MOSW626/Swinging_on_a_swing_Robot_Project_-2021-/src/sketch_aug10e/data/fritzing_sweep.jpg

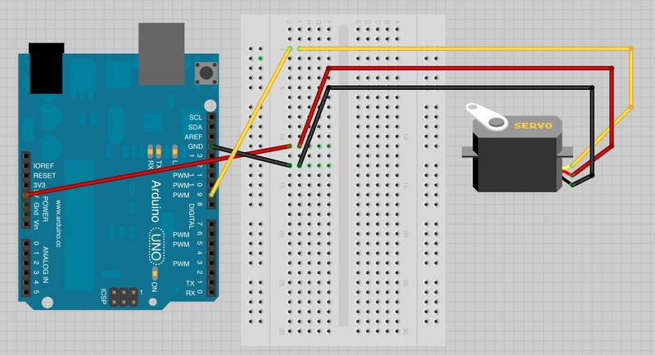
src/sketch_aug10e/data/fritzing_sweep.jpg
