MOSW626/Swinging_on_a_swing_Robot_Project_-2021-/README.md

# Swinging_on_a_swing_Robot_Project_-2021-

## 제 67회 전국과학전람회 작품
 - 지금까지의 과정 업로드용
 - 국무총리상 수상

## language
 : cpp (arduino)
