MOSW626/Swinging_on_a_swing_Robot_Project_-2021-/src/나는 그네를 어떻게 만들까2.pptx

## 나는 그네를 어떻게 만들까?

- 安延洙 -

## 외형

## Slide 3

## Slide 4

FF22DD
FF02FD
FFC23D
FF6897
FF30CF
FF18E7
FF7A85
FF10EF
…

속도 증가
속도 감소
시작 / 정지
가만히 있는 상태로
1번 케이스
2번 케이스
3번 케이스
4번 케이스
…

## Slide 5

적외선 리모컨 프로그래밍

#include <IRemote.h>

Irerecv irrecv(8);
decode_results results;
Void setup()
{
irrecv.enableIRIn();
pinmode(9, OUTPUT);
Serial.begin(9600);
}
Void loop()
{
if(irrecv.decode(&results))
{
Serial.println(results.value, HEX);
if(results.value == 0xFD30CF)
{
digitalWrite(9, HIGH);
}
else {
digitalWrite(9, LOW);
}
delay(30);
irrecv.resume();
}
}

// 적외선 센서가 연결된 디지털 핀
// 수신된 적외선 신호 저장 변수
// 적외선 센서 활성화
// 적외선 신호 해석
// 적외선 신호 값 출력
// 숫자 0 -> LED on
// else off
//초기화

## Slide 6

가속도 센서

라이브러리
=> MPU-6050_library,
I2Cdev_library

## Slide 7

가속도 센서

## Slide 8

레이저 거리 센서

라이브러리
=> vl53l0x-arduino

## Slide 9

레이저 거리 센서

#include <Wire.h>

#include <VL53L0X.h>

VL53L0X sensor;
void setup()
{
Serial.begin(9600);
Wire.begin();
sensor.setTimeout(500);
if (!sensor.init())
{
Serial.println("Failed to detect and initialize sensor!");
while (1) {}
}
// Start continuous back-to-back mode (take readings as
// fast as possible). To use continuous timed mode
// instead, provide a desired inter-measurement period in
// ms (e.g. sensor.startContinuous(100)).
sensor.startContinuous();
}
void loop()
{
Serial.print(sensor.readRangeContinuousMillimeters());
if (sensor.timeoutOccurred()) { Serial.print(" TIMEOUT"); }
Serial.println();
}

## Slide 10

초음파 거리 센서

- 사용전압 : 5V
- 사용전류 : 15mA

라이브러리
=> MPU-6050_library,
I2Cdev_library

## Slide 11

초음파 거리 센서

#define TRIG 9 //TRIG 핀 설정 (초음파 보내는 핀)

#define ECHO 8 //ECHO 핀 설정 (초음파 받는 핀)

void setup() {
Serial.begin(9600); //PC모니터로 센서값을 확인하기위해서 시리얼 통신을 정의해줍니다.
//시리얼 통신을 이용해 PC모니터로 데이터 값을 확인하는 부분은 자주사용되기 때문에
//필수로 습득해야하는 교육코스 입니다.
pinMode(TRIG, OUTPUT);
pinMode(ECHO, INPUT);
}
void loop()
{
long duration, distance;
digitalWrite(TRIG, LOW);
delayMicroseconds(2);
digitalWrite(TRIG, HIGH);
delayMicroseconds(10);
digitalWrite(TRIG, LOW);
duration = pulseIn (ECHO, HIGH); //물체에 반사되어돌아온 초음파의 시간을 변수에 저장합니다.
//34000*초음파가 물체로 부터 반사되어 돌아오는시간 /1000000 / 2(왕복값이아니라 편도값이기때문에 나누기2를 해줍니다.)
//초음파센서의 거리값이 위 계산값과 동일하게 Cm로 환산되는 계산공식 입니다. 수식이 간단해지도록 적용했습니다.
distance = duration * 17 / 1000;
//PC모니터로 초음파 거리값을 확인 하는 코드 입니다.
Serial.println(duration ); //초음파가 반사되어 돌아오는 시간을 보여줍니다.
Serial.print("\nDIstance : ");
Serial.print(distance); //측정된 물체로부터 거리값(cm값)을 보여줍니다.
Serial.println(" Cm");
delay(1000); //1초마다 측정값을 보여줍니다.

## Slide 12

코딩(code-up)
연수와 수빈이와 하린이는 전람회를 나가게 되었습니다. 이때 연수는 아두이노를 프로그래밍 해야 합니다. 이에 주어진 목표는 다음과 같습니다.

리모컨을 이용해서 조종 - FF22DD => 속도 증가 - FF02FD => 속도 감소 - FFC23D => 시작 / 정지 - FF6897 => 가만히 있는 상태로(초기 상태) - FF30CF => Case : 1 - FF18E7 => Case : 2 - FF7A85 => Case : 3 - FF10EF => Case : 4 - FF38C7 => Case : 5 - FF5AA5 => Case : 6 - FF42BD => Case : 7 - FF4AB5 => Case : 8 - FF52AD => Case : 9 중심을 지날 때를 기준으로 sensing하여 서보 모터의 속도를 조절 * Sensing방법 - 초음파 거리 센서 - 6축 가속도 센서 - 레이저 거리 센서 * 속도를 연속적이지 않게 조절 할 수 있도록 설계가 필요!

## Slide 13

Lcd i2c check

#include <Wire.h>

void setup()
{
Wire.begin();
Serial.begin(9600);
while (!Serial);
Serial.println("\nI2C Scanner");
}
void loop()
{
byte error, address;
int nDevices;
Serial.println("Scanning...");
nDevices = 0;
for(address = 1; address < 127; address++ )
{
Wire.beginTransmission(address);
error = Wire.endTransmission();
if (error == 0)
{
Serial.print("I2C device found at address 0x");
if (address<16)
Serial.print("0");
Serial.print(address,HEX);
Serial.println(" !");
nDevices++;
}
else if (error==4)
{
Serial.print("Unknow error at address 0x");
if (address<16)
Serial.print("0");
Serial.println(address,HEX);
}
}
if (nDevices == 0)
Serial.println("No I2C devices found\n");
else
Serial.println("done\n");
delay(5000);
}

## Slide 14

Lcd

#include <LiquidCrystal_I2C.h>

#include <Wire.h>

LiquidCrystal_I2C lcd(0x27, 16, 2);
void setup() {
lcd.init();
lcd.backlight();
}
void loop() {
int value = random(0, 3);
if (value == 0) {
lcd.setCursor(0,0);
` lcd.print(" KocoaFab.cc ");
}
else if (value == 1) {
lcd.setCursor(0,1);
lcd.print(" Hello World!! “);
}
else if (value == 2) {
lcd.setCursor(0,0);
lcd.print(" KocoaFab.cc ");
lcd.setCursor(0,1);
lcd.print(" Hello World!! ");
}
delay(1000);
lcd.clear();
}

## Slide 15
