MOSW626/Swinging_on_a_swing_Robot_Project_-2021-/src/회로도.pptx

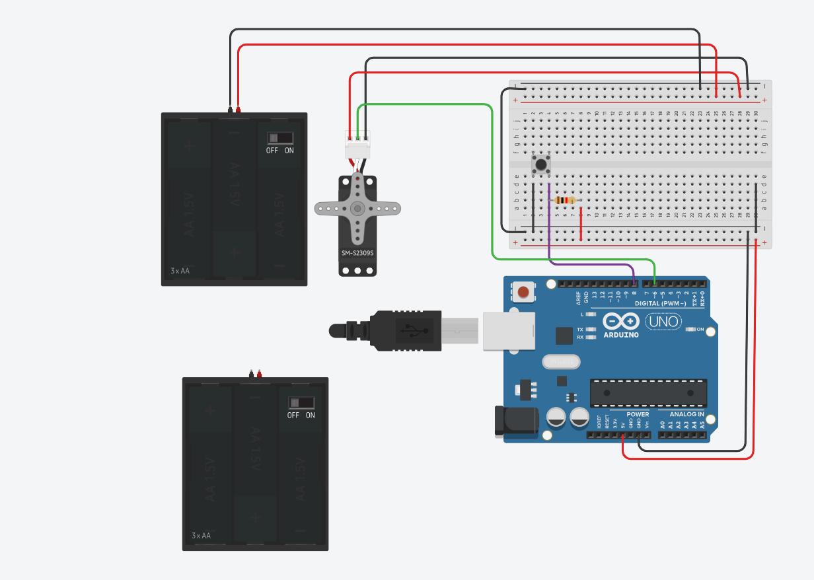
[picture p3: figure]
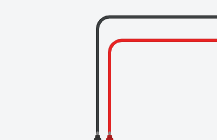
[picture p4: figure]
