MOSW626/Swinging_on_a_swing_Robot_Project_-2021-/j06720211129-1.pdf

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

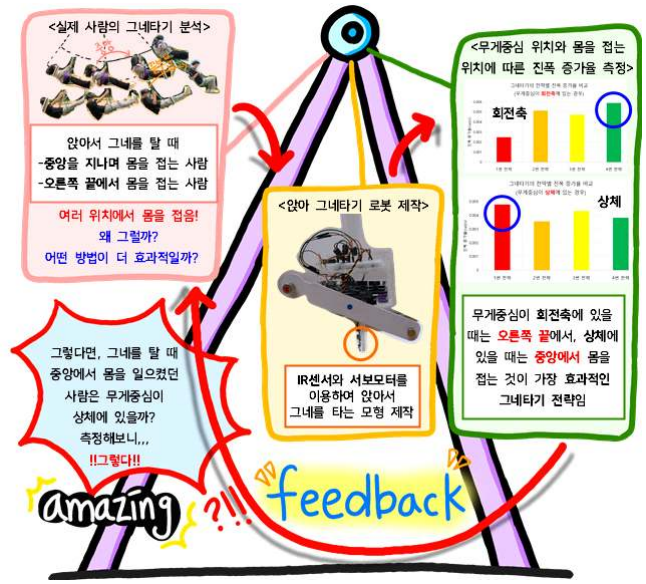
[picture p5: figure]
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
