MOSW626/Swinging_on_a_swing_Robot_Project_-2021-/j06720211129.pdf

### 출품번호

1129

# 제67회 전국과학전람회

# 사람마다 그네를 다르게 타는 이유는? 무게중심 위치에 따른 그네타기 전략 차이 탐구

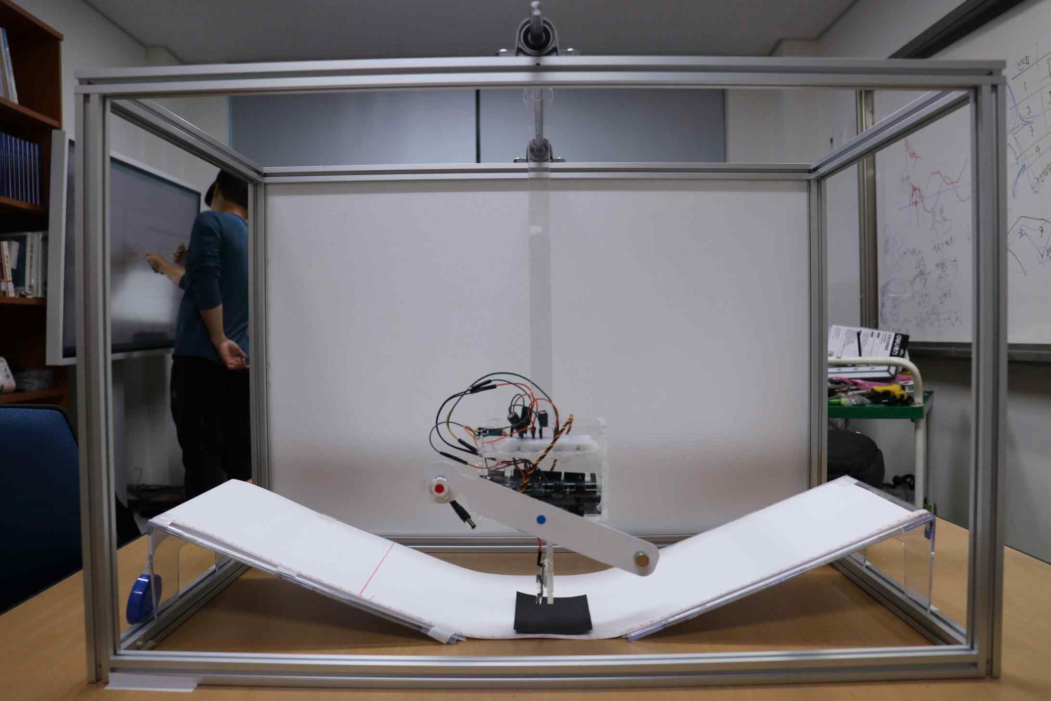
[picture p6: figure]

2021. 9. 6.

## 출품학생

## 지도교사

구분 | 학생작
출품부문 | 물리

【 차 례 】

I. 서론 ·······································································································1
1. 탐구 동기 ·························································································································1
2. 탐구 문제 및 가설 설정 ·······························································································2
3. 탐구 기간 ·························································································································3

### Ⅱ. 이론적 배경 및 선행 연구 조사 ····················································4

1. 역학적 에너지 보존 ·······································································································4
2. 돌림힘, 관성모멘트 및 각운동량 보존법칙 ······························································4
3. 선행 연구 조사 ···············································································································6

Ⅲ. 탐구 내용 ··························································································11

1. 탐구 문제 찾기. 사람은 실제로 어떤 방식으로 그네를 탈까? ····································11 가. 다양한 방법의 실제 그네타기 영상 분석 ·························································11 나. 새로운 탐구 문제 발견 및 탐구 문제 구체화 ·················································16
2. 탐구 준비. 그네 타기 모형(로봇) 만들기 ·································································17 가. 그네 타기 모형(로봇)의 필요성 ·············································································17 나. 그네 타기 모형(로봇) 만들기 ···············································································17 나. 그네 타기 모형(모형)의 작동 알고리즘 ·······························································19
3. 메인 탐구. 몸을 접는 위치에 따른 진폭 증가율 비교 ········································21 가. 실험 설계 및 실험 방법 ·························································································21 나. 실험 결과 ···················································································································23
1) 무게중심이 회전축에 있을 때 진폭 증가율 비교 ···········································23
2) 무게중심이 상체에 있을 때 진폭 증가율 비교 ···············································24
4. 추가 탐구. 메인 탐구 결과의 역도 성립할까? ························································24 가. 메인 탐구 결과를 역으로 실제 그네 타기에 적용 ···········································24 나. 실제 사람의 무게중심 및 회전축의 위치 측정 ·················································25

### Ⅳ. 결론 및 향후 탐구 계획 ································································27

Ⅴ. 참고 문헌 ··························································································28

<그림 차례>
[그림 1[ 앉아서 그네타기에서 몸을 접는 시점이 다른 두 사람 ················································· 1 [그림 2] 역학적 에너지 보존 법칙 ····································································································· 4 [그림 3] 회전운동과 병진운동에서의 식의 비교 ····························································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

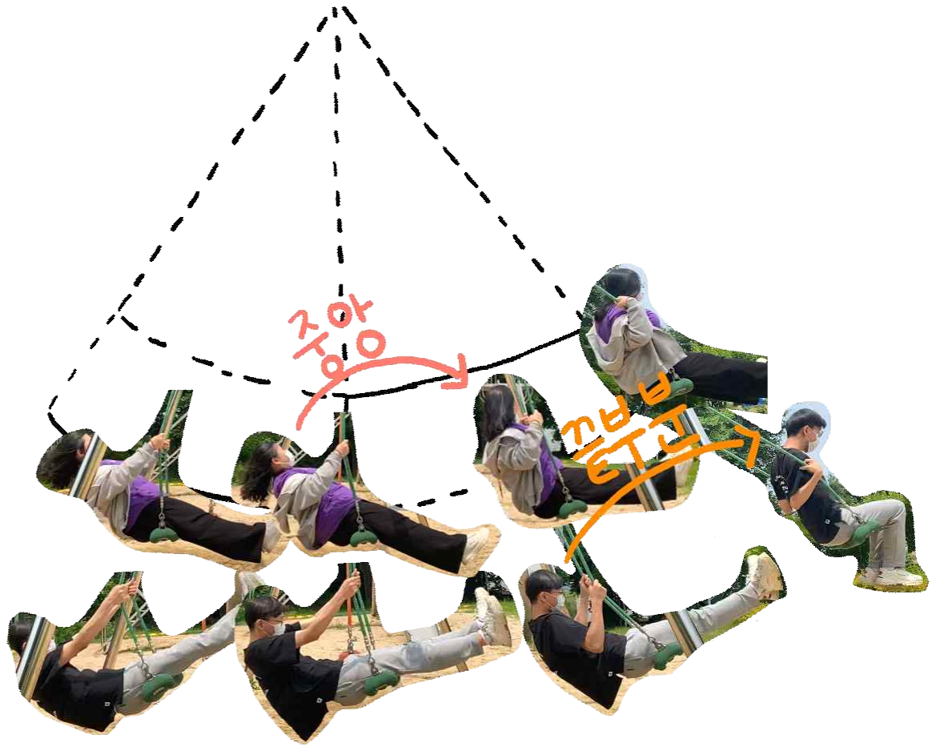
[picture p7: figure]

- 1 -

# Ⅰ 서 론

### 1. 탐구 동기

학교 근처 초등학교에서 어린 동생과 같이 그네를 타러 갔었다. 그네 타기에 어려 움을 겪고 있던 동생에게 그네 타는 방법을 가르쳐 주려는 데, 그네 타는 방법을 명확하게 설명할 수 없었다. 평소 너무도 쉽게 그네를 타고 있었기에 당연히 알고 있다고 생각했던 그네 타기의 역학적 원리를 모르고 있었음을 깨닫고, 이후 학교 물리 동아리에서 ‘어떻게 하면 그네를 잘 탈 수 있을까?’라는 주제로 토론을 진 행하게 되었다. 토론을 해보니 사람마다 그네를 타는 방법이 다양했고, 무엇보다도 자신이 어떻게 그네를 타는지 명확하게 설명할 수 있는 사람이 거의 없었다. 이런 궁금증으로 그네 타기를 주제로 탐구를 시작하였는데, 인터넷 조사를 통해

그네 타기의 역학적 원리에 대해 알아보니 기본 원리가 잘 설명되어 있어서 막상 우리가 탐구 해야할 문제를 찾기가 어려웠다. 그래서 처음에는 탐구 문제를 찾기 위해 다양한 방법으로 그네를 타기도 하고, 그네 타기를 표현할 수 있는 그네 타기 로봇 모형을 만들어 실험을 해 보기도 하였다.

[그림 1[ 앉아서 그네타기에서 몸을 접는 시점이 다른 두 사람

그러다가 앉아서 그네 타기에서 몸을 일으키는 시점이 이론과 다름에도 그네를 잘 타는 사례를 발견하고 탐구 문제로 구체화 하였다.

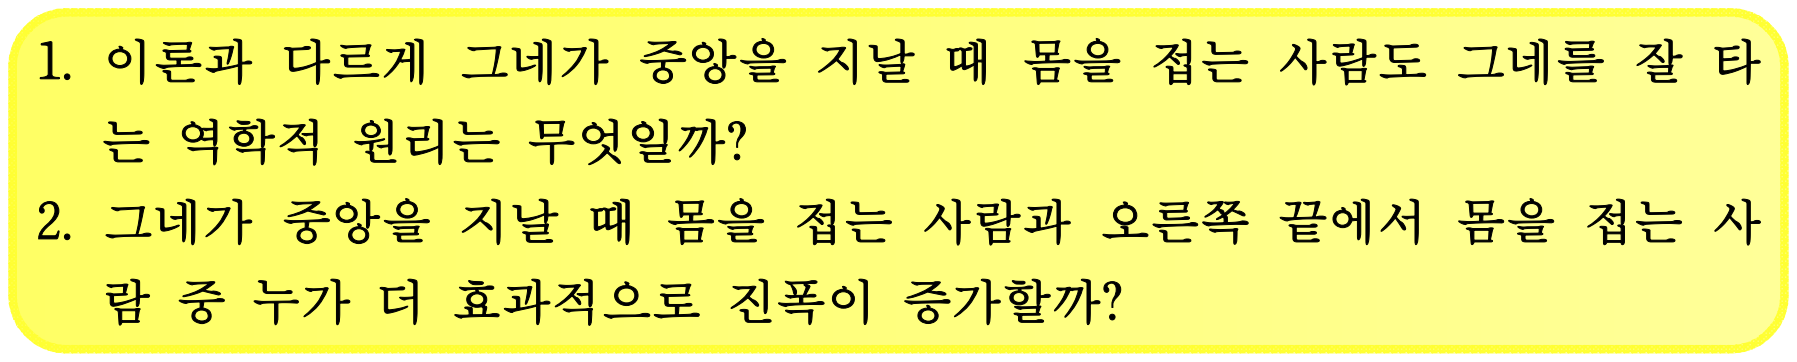
[picture p8: figure]
역학적; 원리는; 무엇일까?; 효과적으로; 진폭이; 증가할까?
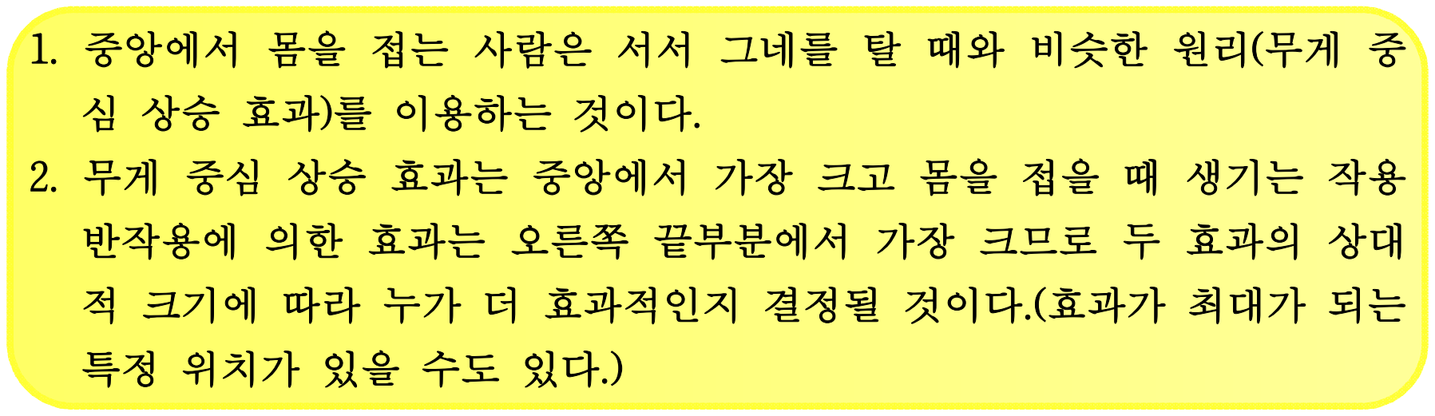
[picture p9: figure]
반작용에; 효과는; 오른쪽; 끝부분에서; 크므로; 효과의; 크기에; 효과적인지; 결정될; 것이다.(효과가; 최대가; 위치가
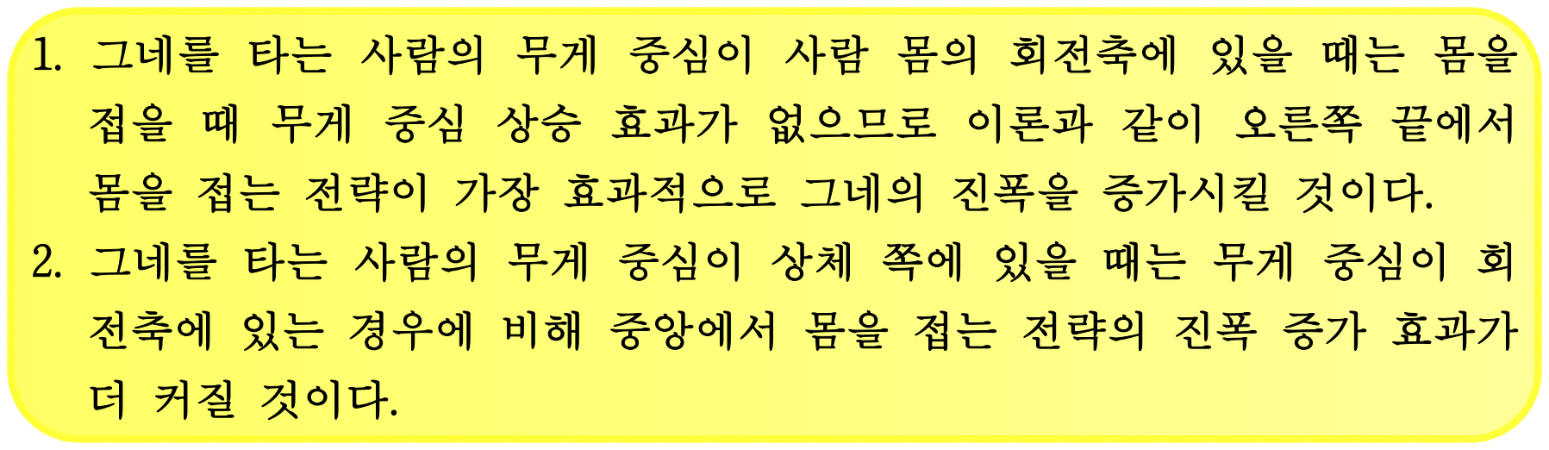
[picture p10: figure]
효과가; 없으므로; 이론과; 오른쪽; 끝에서; 전축에; 경우에; 중앙에서; 전략의; 것이다.

- 2 -

### 2. 탐구 문제 및 가설 설정

선행 연구와 이론에 따르면 앉아서 그네 타기는 오른쪽 끝(최고점)에서 몸을 접을 때 가장 효과적으로 진폭이 증가한다고 하였다. 그런데 우리가 직접 그네를 타면서 발견한 사례 중 하나는 그네가 중앙(최저점)을 지날 때 몸을 접으면서도 그네를 잘
타는 | 사례였다. 우리는 | 이것을 | 탐구 | 문제로 | 삼고 | 다음과 | 같이 | 구체화 | 하였다. 탐구 | 문제
1. | 이론과 | 다르게 | 그네가 | 중앙을 | 지날 | 때 | 몸을 | 접는 | 사람도 | 그네를 | 잘 | 타
2. | 그네가 | 중앙을 | 지날 | 때 | 몸을 | 접는 | 사람과 | 오른쪽 | 끝에서 | 몸을 | 접는 | 사
이러한 | 탐구 | 문제에 | 대한 | 우리의 | 예상 | 답변은 | 다음과 | 같다. 예상 | 답변
1. | 중앙에서 | 몸을 | 접는 | 사람은 | 서서 | 그네를 | 탈 | 때와 | 비슷한 | 원리(무게 | 중
심 | 상승 | 효과)를 | 이용하는 | 것이다. 2. | 무게 | 중심 | 상승 | 효과는 | 중앙에서 | 가장 | 크고 | 몸을 | 접을 | 때 | 생기는 | 작용
이러한 | 예상 | 답변을 | 검증 | 가능한 | 내용으로 | 정리한 | 우리의 | 가설은 | 다음과 | 같다. 가설 | 설정
1. | 그네를 | 타는 | 사람의 | 무게 | 중심이 | 사람 | 몸의 | 회전축에 | 있을 | 때는 | 몸을
몸을 | 접는 | 전략이 | 가장 | 효과적으로 | 그네의 | 진폭을 | 증가시킬 | 것이다. 2. | 그네를 | 타는 | 사람의 | 무게 | 중심이 | 상체 | 쪽에 | 있을 | 때는 | 무게 | 중심이 | 회

- 3 -

### 3. 탐구 기간

연구내용 | 추진 시기(월)
4월 | 5월 | 6월 | 7월 | 8월
초 | 중 | 말 | 초 | 중 | 말 | 초 | 중 | 말 | 초 | 중 | 말 | 초 | 중 | 말
탐구 주제 선정 | ▶ | ▶ | | | | | ▶ | ▶ | ▶
선행 연구 조사 및 분석 | | ▶ | ▶ | ▶ | ▶ | ▶ | ▶ | ▶ | ▶
이론적 배경 파악 | | ▶ | ▶ | ▶ | ▶ | ▶ | ▶
탐구설계 | | | | ▶ | ▶ | ▶ | ▶ | ▶ | ▶ | ▶ | ▶ | ▶
탐구 수행 | | | | | ▶ | ▶ | ▶ | ▶ | ▶ | ▶ | ▶ | ▶ | ▶ | ▶ | ▶
그네 모형 제작 | | | | | | ▶ | ▶ | ▶ | | | ▶ | ▶ | ▶ | ▶
결과 정리 및 보고서 작성 | | | | | | ▶ | ▶ | ▶ | | | | ▶ | ▶ | ▶ | ▶

<표 1> 탐구 기간 및 절차

4월에 탐구를 시작할 때는 막연하게 그네 타기의 역학적 원리에 대한 궁금증에서 시작하였다. 선행 연구와 인터넷 자료 조사를 통해 기본적인 원리를 파악할 수 있 었지만 우리가 탐구 해야 할 주제를 구체화 하는데 어려움이 있었다. 그래서 구체 적인 탐구 문제를 발견하기 위해 직접 그네를 타기도 하고, 로봇을 만들어 실험을 해 보기도 하던 중 탐구 문제를 발견하여 구체화하고 그에 따른 새로운 실험 설계 와 로봇 제작을 통해 탐구를 진행하였다. 이러한 탐구 과정을 위 <표 1>에 나타내 었다.

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

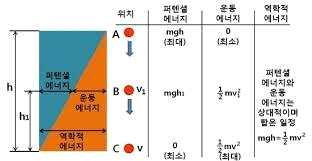
[picture p11: figure]

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

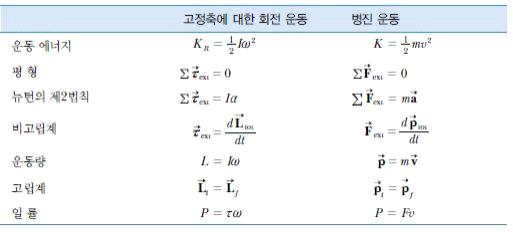
[picture p12: figure]
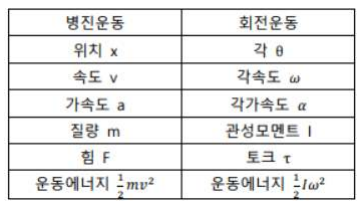
[picture p13: figure]

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

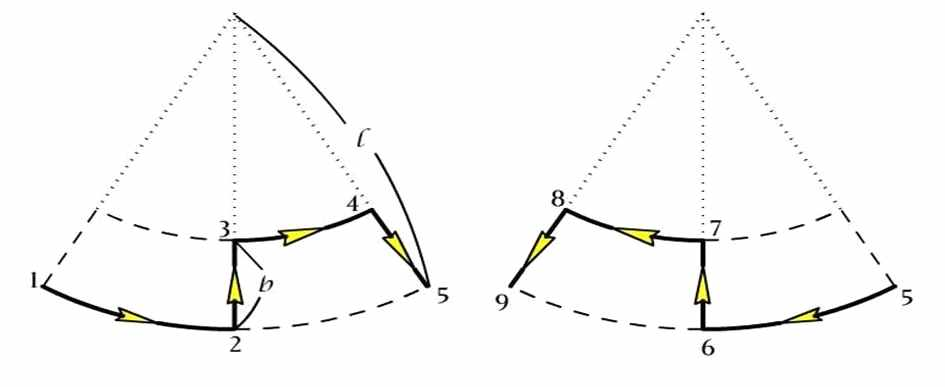
[picture p14: figure]

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

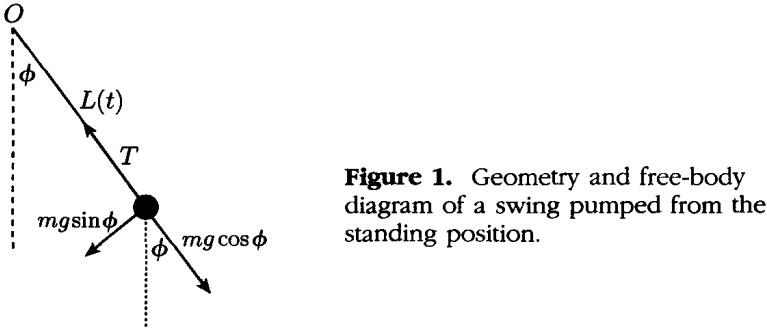
[picture p15: figure]

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

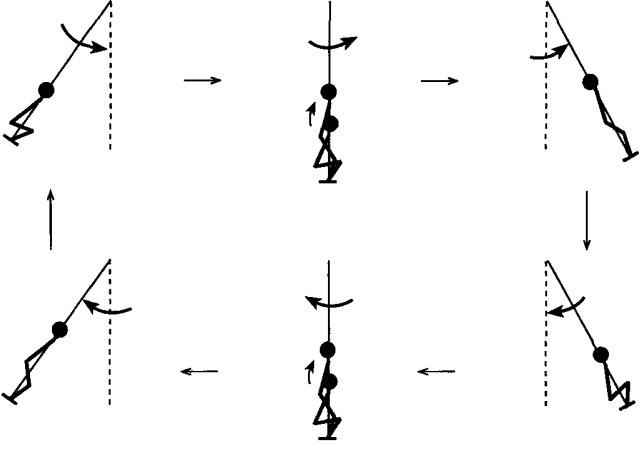
[picture p16: figure]
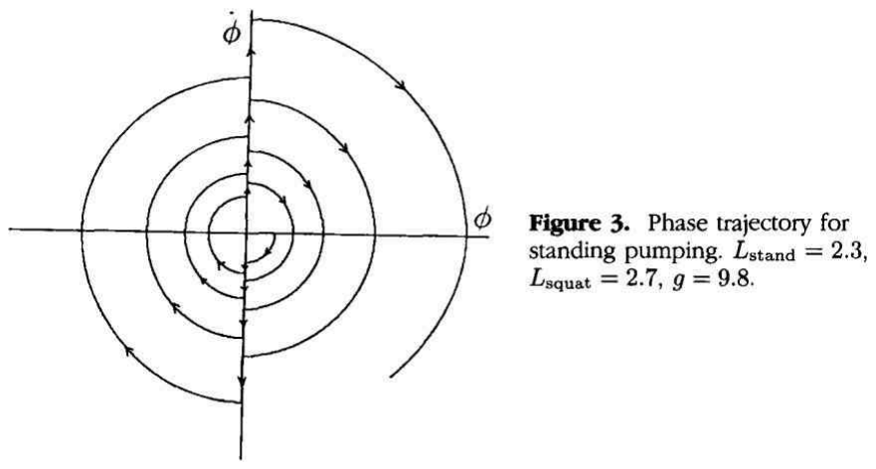
[picture p17: figure]

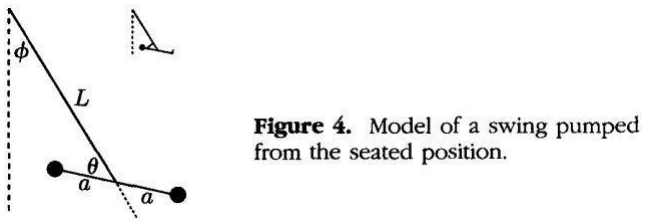
[picture p18: figure]
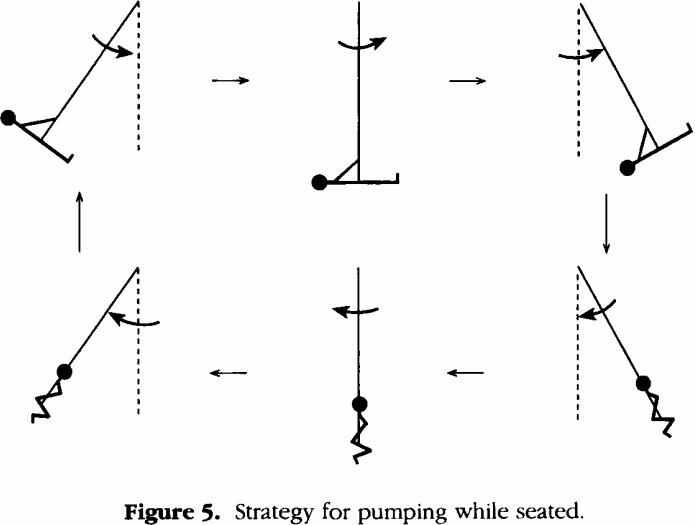
[picture p19: figure]

- 9 -

[그림 9] 앉아 타는 그네의 단순 모형

[그림 9]은 사람이 그네를 탈 때를 좌우에 각각 1:1 질량비의 바벨(barbell)을 달아 표현하였고, 강체의 줄과 두 바벨 사이의 강체가 이루는 각 을 설정하여 변수를 하나 더 늘렸다. 앉아 타는 그네는 [그림 9]처럼 간단한 모식도를 통해 나타낼 수 있다. 이를 서서 타는 그네와 같은 방법으로 중력과 돌림힘의 관계를 수식을 정리

하면

sin으로 나타낼 수 있다.

[그림 10] 앉아 타는 그네의 모식도
이 식을 [그림 10]의 상황에 적용하면 최고점 또는 이 0인 아주 짧은 시간에

를 변화시킴으로써 그 반작용으로 반대 방향의 의 변화를 만들어 내는 방법으로 그네를 타는 것을 알 수 있다. 이를 위상 공간에 나타내면 [그림 11]과 같은 각속도

-각변위 그래프를 얻을 수 있다.

인 지점, 즉 그네 타기에서의 최고점에서 가

증가하는 모습을 볼 수 있다.

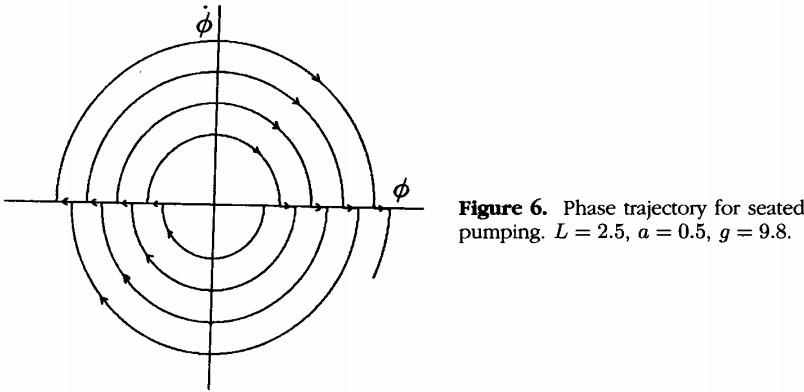
[picture p20: figure]
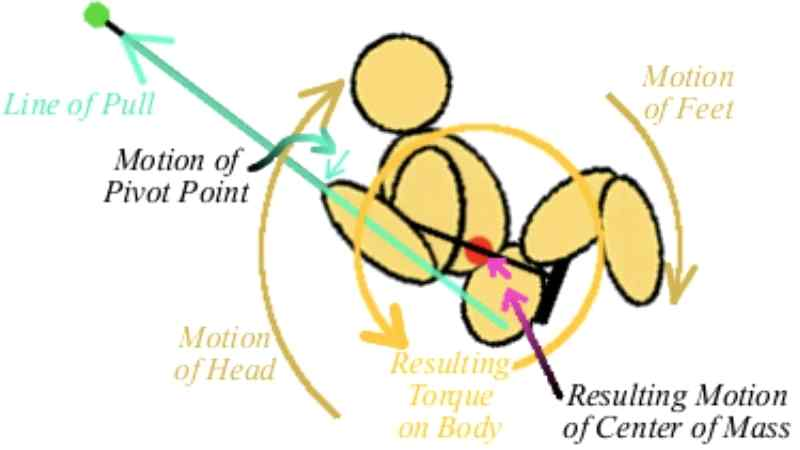
[picture p21: figure]

- 10 -

[그림 11] 앉아 타는 그네의 각속도-각변위 그래프

### 다. 나! 그네, KOSMOS (KAIST부설 한국과학영재학교 온라인 과학매 거진 코스모스) 이준민 (2020)

내용 요약 | 본 탐구와 다른 점
서서 타는 그네와 앉아서 타는 그네의 물리적 원리를 각운동량 보존법칙과 역 학적 에너지 보존법칙, 그리고 돌림힘 을 통해 설명하고, 두 그네 타기 모델 에 대하여 | 앞에서 소개한 선행 연구들의 내용을 재해석하여 정리한 문헌으로서 탐구를 진행한 내용은 아니다.

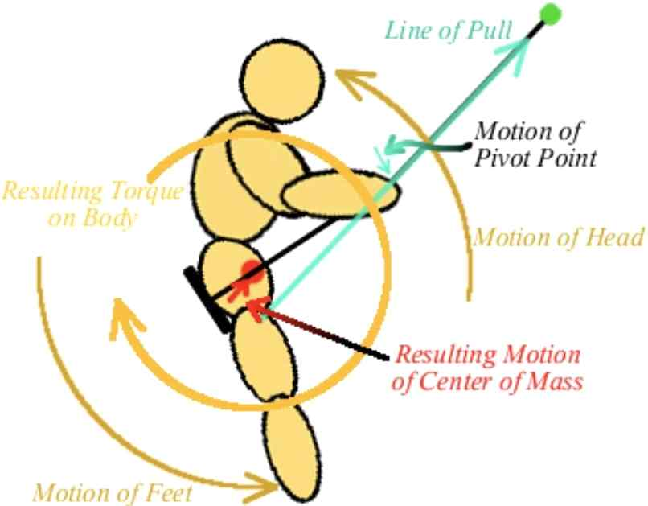
[picture p22: figure]

서서 그네 타기의 물리적 원리와 앉아서 그네 타기의 원리에 대해 설명한다. 위에 서 소개한 선행 연구의 내용과 거의 같으나 앉아서 타는 모델에서 그네의 줄을 강 체로 설정하지 않고 꺾이는 것으로 설명하는 점이 다르다.
또한 그네 타는 동작을 세분화해서 학습시킨 후, 그 동작들 중에 가장 높이 올라 가는 것을 다시 골라내 마치 다윈의 자연선택설처럼 반복하면 나오는 모델이 그네
[그림 12] 앉아 타는 그네의 돌림힘(1) | [그림 13] 앉아 타는 그네의 돌림힘(2)

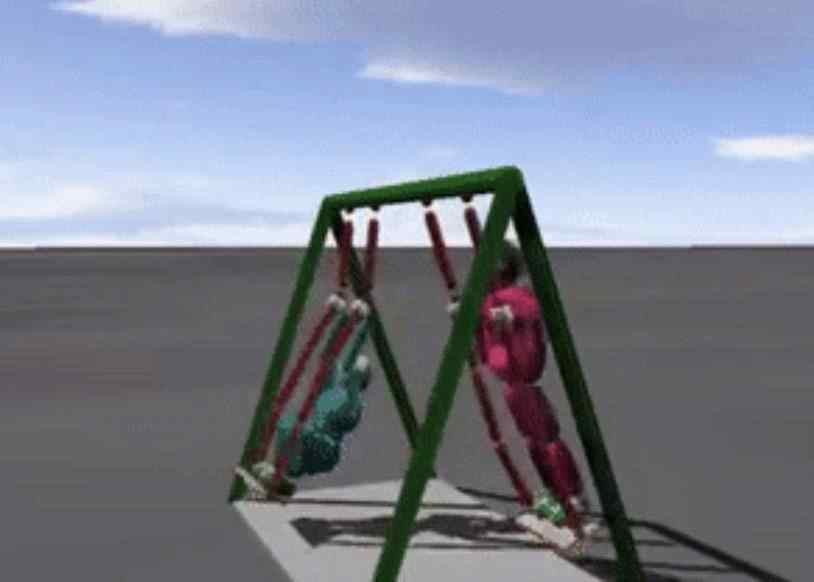
[picture p23: figure]
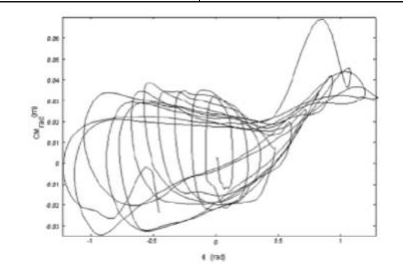
[picture p24: figure]

- 11 -

를 잘 탄다는 유전 알고리즘을 소개하고
있다. 이 연구는 이론적인 설명과 연구
사례를 소개하였을 뿐 실제 실험을 통해
진행한 부분은 없다. 우리는 실제 사람의
그네타는 영상을 분석하고, 그네 타는 로
봇을 만들어 선행연구에서 설명하는 그네
타기 원리가 실제 상황에 어떻게 적용되
는지 알아고보자 하며 나아가서는 유전
알고리즘 등을 활용하여 최적의 그네 타

### 는 방법에 대해 알아내고자 한다. 라. Pumping a playground swing, Auke A. Post 외 3인 (2007)

[그림 15] 실제 앉아서 그네타기에서 무게 중심의 이동

마. The pumping of a swing from the seated position, William B.

Case 외 1인 (1999) 앉아서 그네 타기의 원리를 요약 정리한 교육 논문.

[그림 14] 유전적 알고리즘 실행 장면

내용 요약 | 본 탐구와 다른 점
30명의 사람들을 표본 집단으로 하여 그네 를 태우고, 그네 회전축과 사람 사이 각도 에 따른 무게중심 위치 그래프 등을 통해 실제 사람들이 그네를 어떻게 타는지 설명 하였다. | 실제 그네 타는 사람의 모습을 정량적으로 분석하였으나, 본 연구처럼 사람의 무게중 심이나 체형에 따른 연구는 아니다.

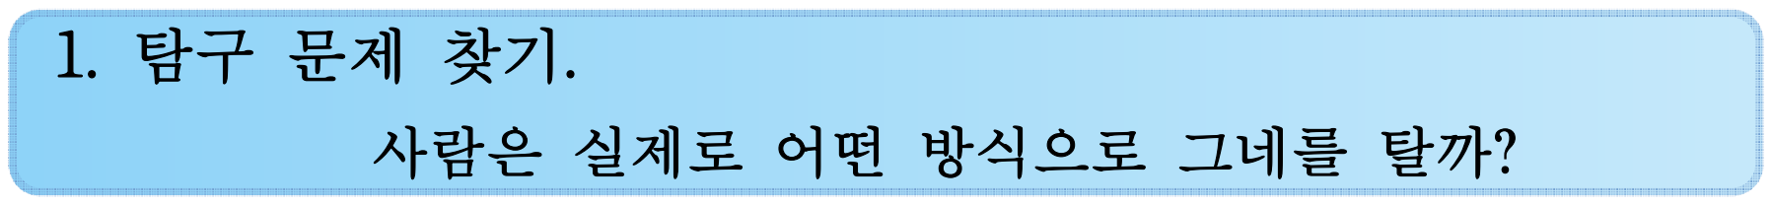
[picture p25: figure]
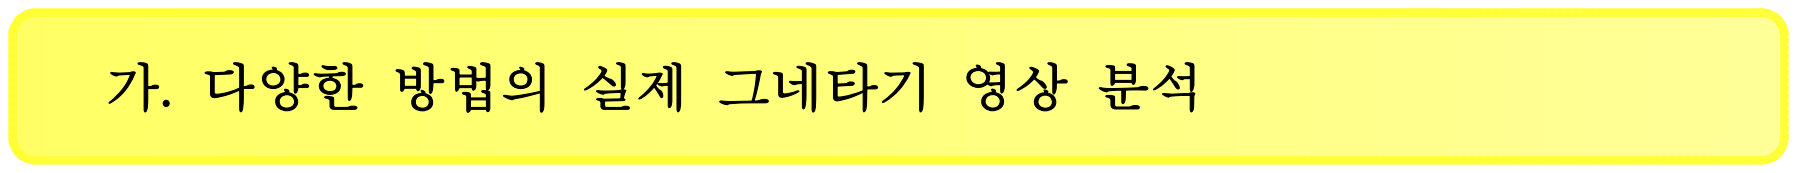
[picture p26: figure]
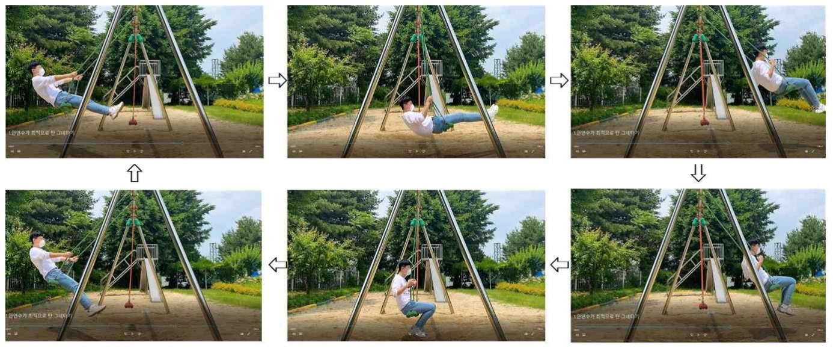
[picture p27: figure]

- 12 -
사람은 | 실제로 | 어떤 | 방식으로 | 그네를 | 탈까? 가. | 다양한 | 방법의 | 실제 | 그네타기 | 영상 | 분석
1) 다양한 방법의 실제 그네 타기 영상 촬영
실제 그네 타기를 분석하여 기존 연구와 어떻게 다른지 알아보기로 하였다. 이를 위해 인근 초등학교에 직접 가서 여러 가지 상황을 설정하여 그네타기 영상을 촬영
하였다. 상황 | 상체 | 다리 | 감속/

가속

1. 변수를 제한하지 않고 마음대로 그네 타기 | ○ | ○ | 가속
2. 다리를 움직이지 않고 상체만 움직인 그네 타기 | ○ | × | 가속
3. 상체를 움직이지 않고 다리만 움직인 그네 타기 | × | ○ | 가속
4. 3번 경우에서 반대로 다리를 움직여 감속을 시킨 그네
타기 | × | ○ | 감속

표 6 다양한 그네 타기 방안

상황 1. 변수를 제한하지 않고 마음대로 그네 타기

[그림 16] 변수를 제한하지 않고 마음대로 그네 타기

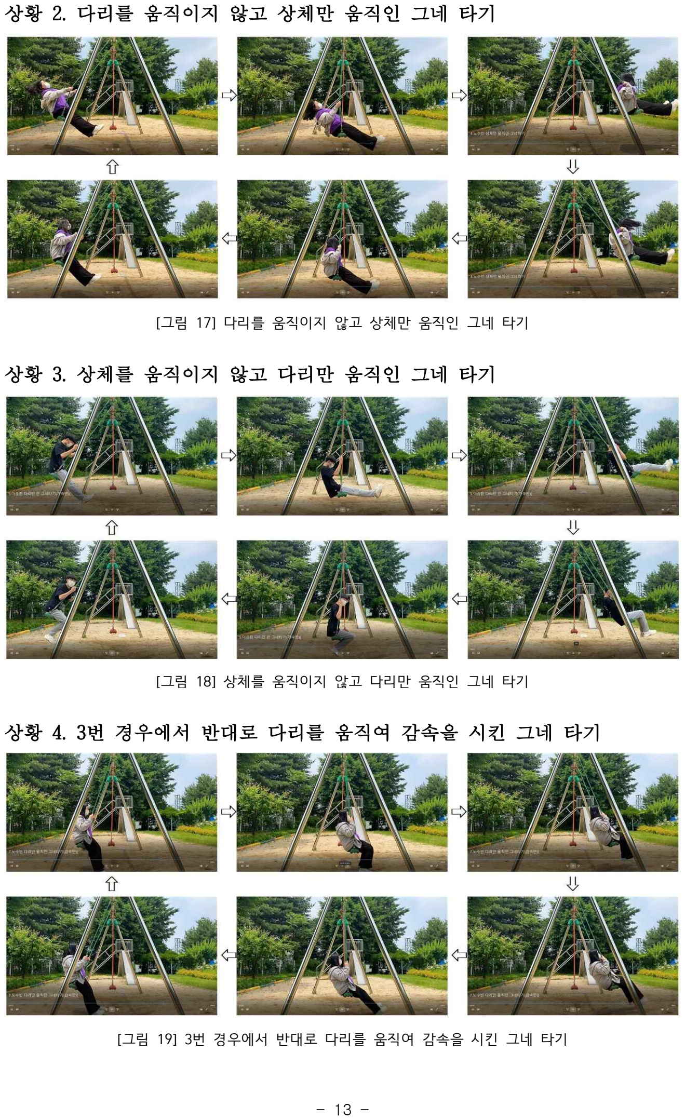
[picture p28: page 16]

- 13 -

상황 2. 다리를 움직이지 않고 상체만 움직인 그네 타기

[그림 17] 다리를 움직이지 않고 상체만 움직인 그네 타기

상황 3. 상체를 움직이지 않고 다리만 움직인 그네 타기

[그림 18] 상체를 움직이지 않고 다리만 움직인 그네 타기

상황 4. 3번 경우에서 반대로 다리를 움직여 감속을 시킨 그네 타기

[그림 19] 3번 경우에서 반대로 다리를 움직여 감속을 시킨 그네 타기

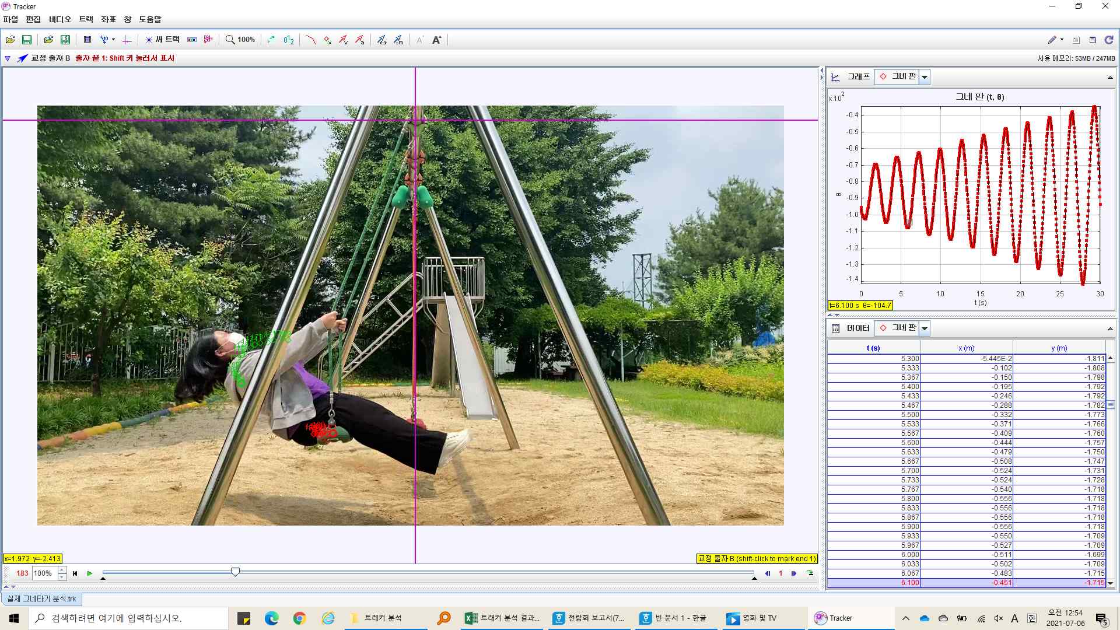
[picture p29: figure]

- 14 -

이와 같이 다양한 방법으로 그네를 타는 영상을 촬영해 관찰해 본 결과 선행 연 구에서 설명한 내용과 어느 정도 비슷한 경향을 보인다. 그네가 오른쪽 끝에 왔을 때 몸을 당기고 다리를 굽히며, 그네가 왼쪽 끝에 왔을 때 몸을 눕히고 다리를 펴 는 행동을 할 때 그네가 잘 가속되는 모습을 보였고 반대로 그네가 오른쪽 끝에 왔 을 때 다리를 펴고 왼쪽 끝에 왔을 때 다리를 굽히는 방법으로 그네를 탔을 때 진 폭이 점점 줄어드는 모습을 관찰할 수 있었다.
그러나 선행 연구에서는 아주 짧은 시간에 순간적으로 몸을 눕히거나 다리를 펴 는 행동 등을 하는 것으로 설정하여 계산하였는데 실제 그네타기에서는 순간적으로 움직이려면 무한대에 가까운 가속도와 힘이 필요하므로 그럴 수 없다. 즉, 어느 정 도 시간을 가지고 천천히 몸을 눕히거나 다리를 접는 행동을 하는 것이다. 이에 대

### 해 정확히 알아볼 필요를 느꼈다. 2) Tracker를 이용한 실제 그네 타기 영상 분석

위에서 설정한 상황 1과 같이 몸과 다리를 모두 사용한 그네 타기 영상을 Tracker로 분석하였다. 가) 탐구 방법

1초에 30프레임인 동영상을 15초간 각각 그네와 어깨에 질점을 찍는다. 30(1초에 30프레임)×15(최대 20초간)×2(그네와 줄에 질점을 찍어)=1200개의 질점을 찍어 시 간에 따른 두 질점의 위치 데이터를 얻고 Excel 프로그램을 이용하여 그네 각도() 와 그네 각속도(), 사람 각도()를 구하여 그래프로 나타내었다.

[그림 20] 그네 타기 Tracker 분석 장면

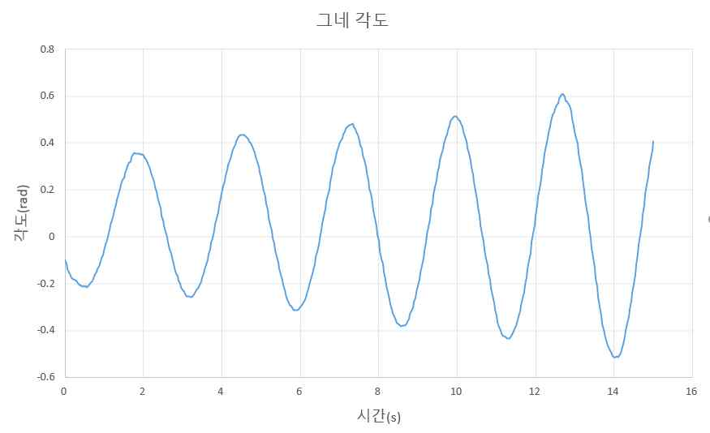
[picture p30: figure]
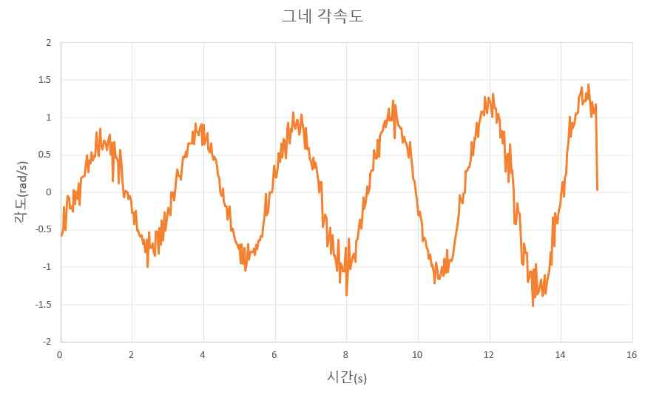
[picture p31: figure]
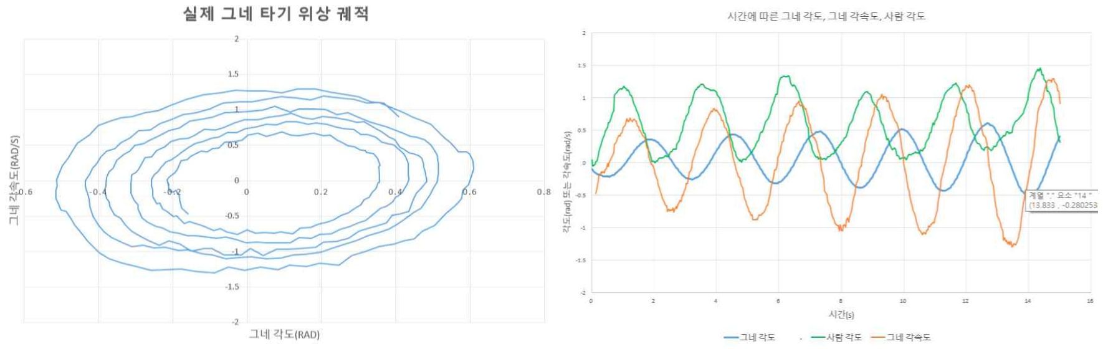
[picture p32: figure]

- 15 -

나) 탐구 결과 분석

[그림 21] 시간에 따른 그네 각도 그래프 | [그림 22] 시간에 따른 그네의 각속도 그래프

시간에 따른 그네 각도와 각속도는 [그림 21, 22]와 같이 점점 진폭이 커지는 모습 을 보였다. 그네의 움직임을 위상 공간에 나타내면 위 [그림 23]과 같이 나선형으로 점점 진폭

이 커지는 모습을 볼 수 있다. 그러나 선행 연구에서와 같이 한순간에 속도나 변위 가 커지는 모습은 볼 수 없으며 연속적으로 증가하는 모습을 볼 수 있다.

[그림 23] 그네 운동의 위상 공간 궤적 그래프 | [그림 24] 그네 각도, 각속도, 사람 각도 시간에 따른 그네 각도, 각속도, 사람 각도를 함께 나타내면 [그림 24]와 같다. 그

네 각속도 변화가 거칠어서 알아보기 쉽도록 Excel의 추세선으로 대체하였다. 그네가 오른쪽으로 갈 때와 왼쪽으로 갈 때 모두 그네가 중앙(각도가 0인 위치)을 지난 후 사람 각도의 변화가 커지고 그에 따라 속도가 커지는 모습을 볼 수 있다. (자세히 보면 그네 속도 그래프의 봉우리가 오른쪽이 조금 더 두껍다.)

다) 이론과 실제 그네 타기 비교
선행 연구에서는 그네가 중앙을 지날 때 순간적으로 일어섬으로써 무게중심이 순 간적으로 올라가면서 그네의 속도가 빨라지는 방법과 그네가 양 끝에 있을 때 사람 의 각도 변화를 순간적으로 줌으로써 그네의 각변위가 증가하는 방법에 의해 그네 를 탄다고 설명하고 있다. 또한 실제로 우리가 그네를 타고 촬영하여 분석한 결과로는 앉아서 그네를 탈 때

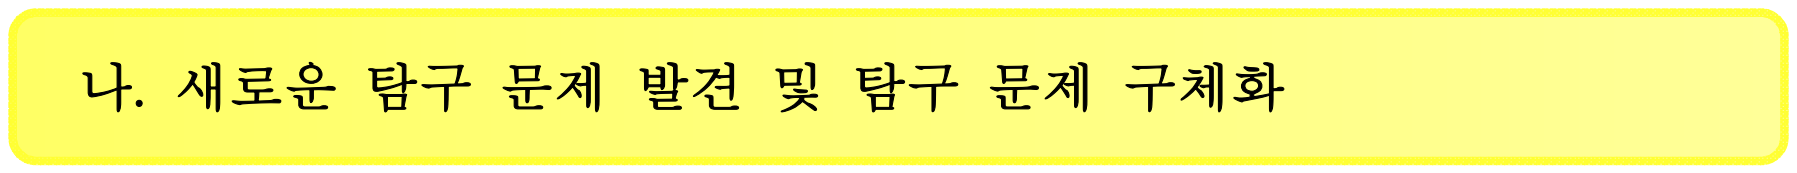
[picture p33: figure]
새로운; 구체화
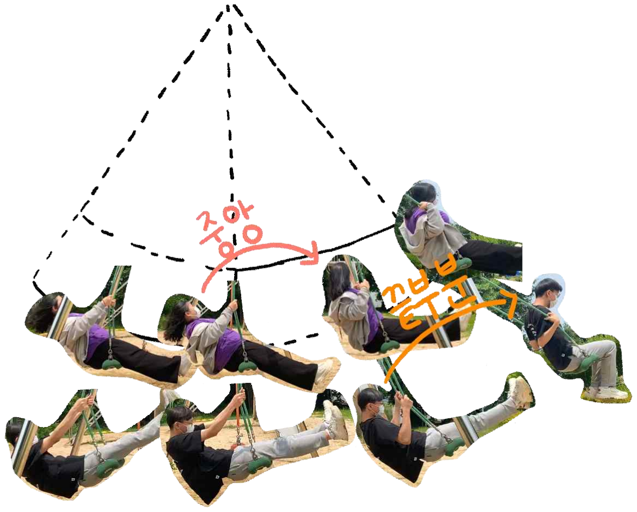
[picture p34: figure]

- 16 -

도 서서 그네 타기의 주된 방식인 ‘무게 중심 상승에 의한 속도 증가 효과’를 이 용하는 사람도 있는 것으로 보였지만, 그네의 진폭 증가 과정이 연속적이고 복합적 으로 작용했다는 것을 제외하면 선행 연구에서 언급한 두 가지 원리가 잘 적용되는 듯 보였다.

이론과 실제의 비교 결과, 실제 그네 타기도 선행 연구에서 설명한 그네 타기와 별반 다르지 않아서 구제적인 탐구 문제를 정하기 못하고 계속 실제 그네 타기 영 상을 분석하고 있었다. 그러던 어느날 그네를 타는 우리들의 모습을 보던 중, ‘어? 우리들 각자 그네 타는 방법이 조금씩 다르네..!’라는 생각이 들었고, 좀 더 자세히 관찰하자 사람마다 몸을 접는 위치가 조금씩 다르다는 점을 발견할 수 있었다.

[그림 25] 앉아서 그네타기에서 몸을 접는 시점이 다른 두 사람 그네가 중앙(최하점)을 지날 때 몸을 접기 시작하는 사람이 있었고, 그네가 오른쪽 끝(최고점)에 거의 도달했을 때 몸을 접는 사람도 있었다. 여기서 우리는 이 두 사람이 ‘무게 중심 상승 효과’와 ‘돌림힘의 작용 반작용

효과’중 어떤 것을 주로 사용할지 궁금증이 생겼고, ‘이 둘 중 어느 전략이 더 효과적으로 빠르게 진폭을 증가시키는 전략일지 궁금해졌다.’
그래서 우리는 이 두 가지 궁금증을 새로운 탐구 문제로 정하고 이후의 탐구를 진 행하였다.

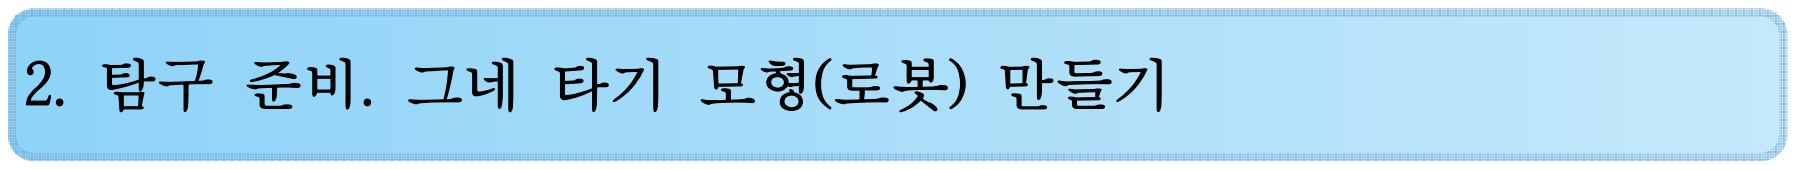
[picture p35: figure]
만들기
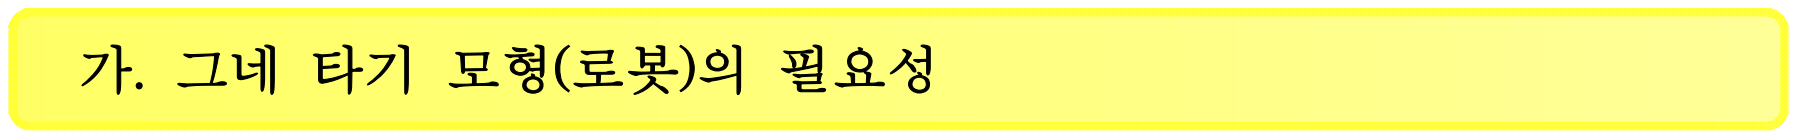
[picture p36: figure]
필요성
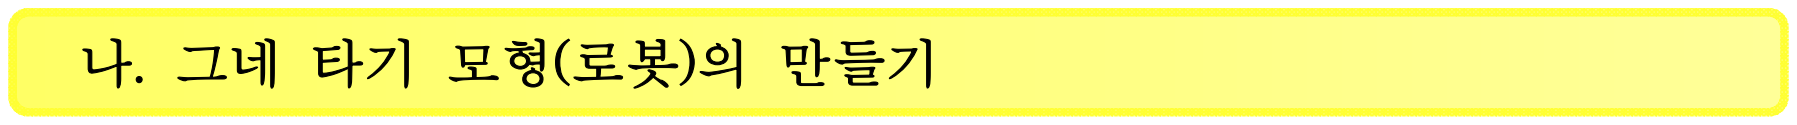
[picture p37: figure]
만들기
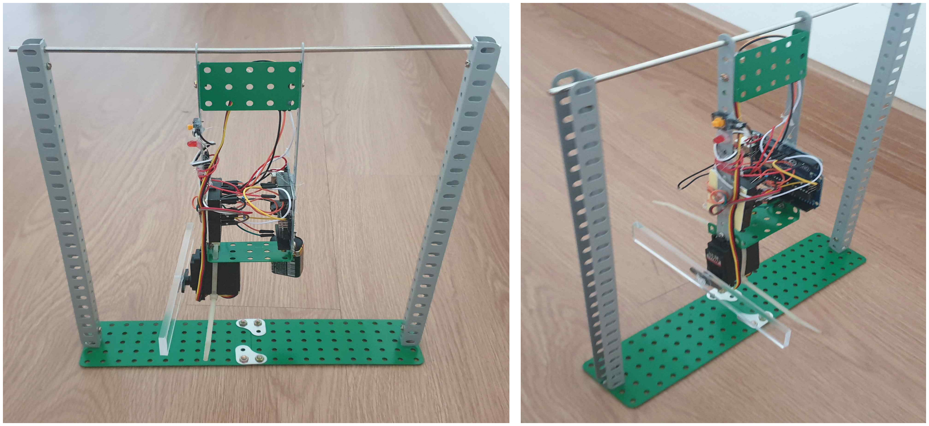
[picture p38: figure]

- 17 -

구체적인 탐구 문제를 발견한 후, 처음에는 사람이 직접 그네를 타면서 몸을 접 는 시점을 달리하면서 그네의 진폭이 커지는 속도를 측정하고자 했다. 그러나 매번 일정한 위치에서 몸을 접는 것도 불가능했고, 다리를 접거나 팔을 당기는 등의 행 동을 통제하기가 어려워서 우리가 조작할 변인인 ‘몸을 접는 위치(시점)’를 조작 할 수 있으면서도 다른 변인은 통제가 되는 로봇을 만들 필요가 있었다.

1) 근근이 탄생

[그림 26] 처음 제작한 앉아서 그네 타기 로봇(근근이 1호) 과학상자를 이용해 그네를 만들고 ]아크릴판으로 사람의 몸을 나타내었다. 서보모 터와 아두이노로 아크릴판을 움직이는데, 센서 없이 미리 입력해 놓은 주기와 각도 로 아크릴판이 시계 방향과 반시계 방향으로 반복적으로 움직이도록 하였다. 사람 의 몸을 나타내는 아크릴판을 이후의 설명에서는 ‘근근이’로 부르겠다. 그네의 고유 주기(약 0.84초)와 근근이가 움직이는 주기를 정확하게 맞추자 그네의

진폭이 점점 커지는 모습을 관찰할 수 있었다. 그러나 주기가 조금만 달라져도(0.01 초) 그네의 진폭이 커지지 않았다. 우리가 실제 그네를 탈 때는 고정된 주기로 움직이는 것이 아니라 그네의 움직임

에 맞추어 우리의 몸을 움직이므로 근근이에게도 그네의 위치를 알 수 있는 센서가 필요하다고 생각하였다. 또한 그네의 크기가 작아서 주기가 짧아서 눈으로 그네의 정확한 움직임을 관찰하

기 어려웠고, 서보모터의 힘이 약해 근근이의 무게를 늘렸을 때 제대로 움직이지 못하는 문제도 있었다.

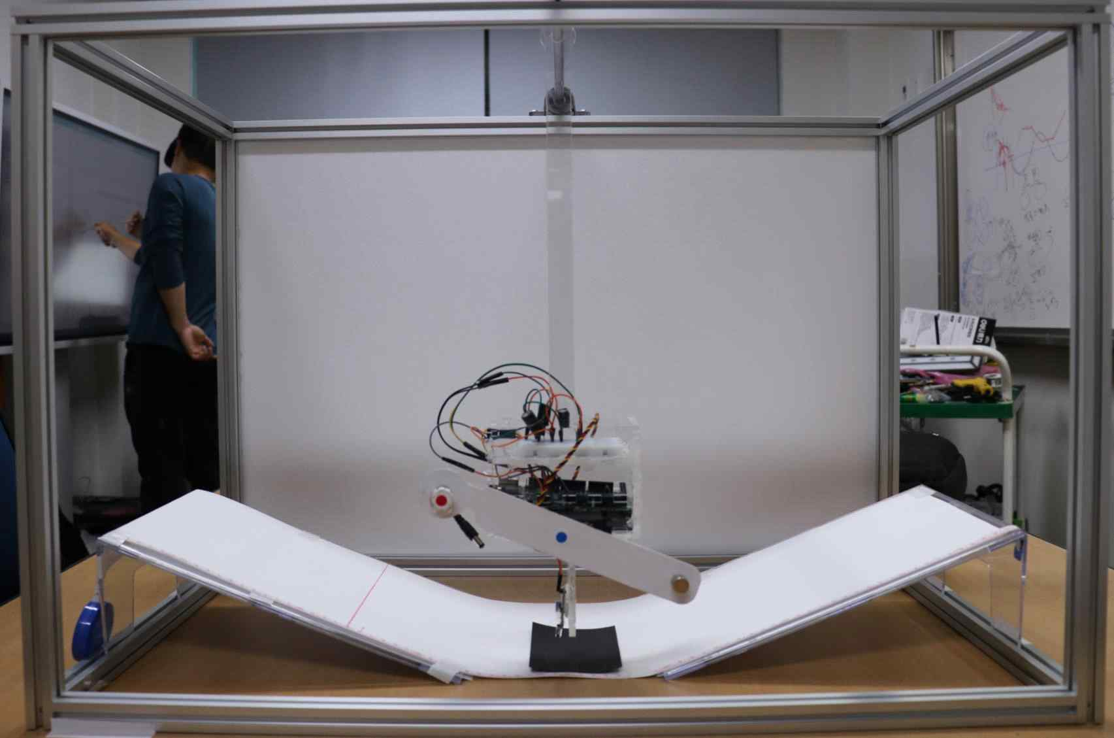
[picture p39: figure]

- 18 -
2) 근근이 진화

[그림 27] 근근이 4호 정면 모습

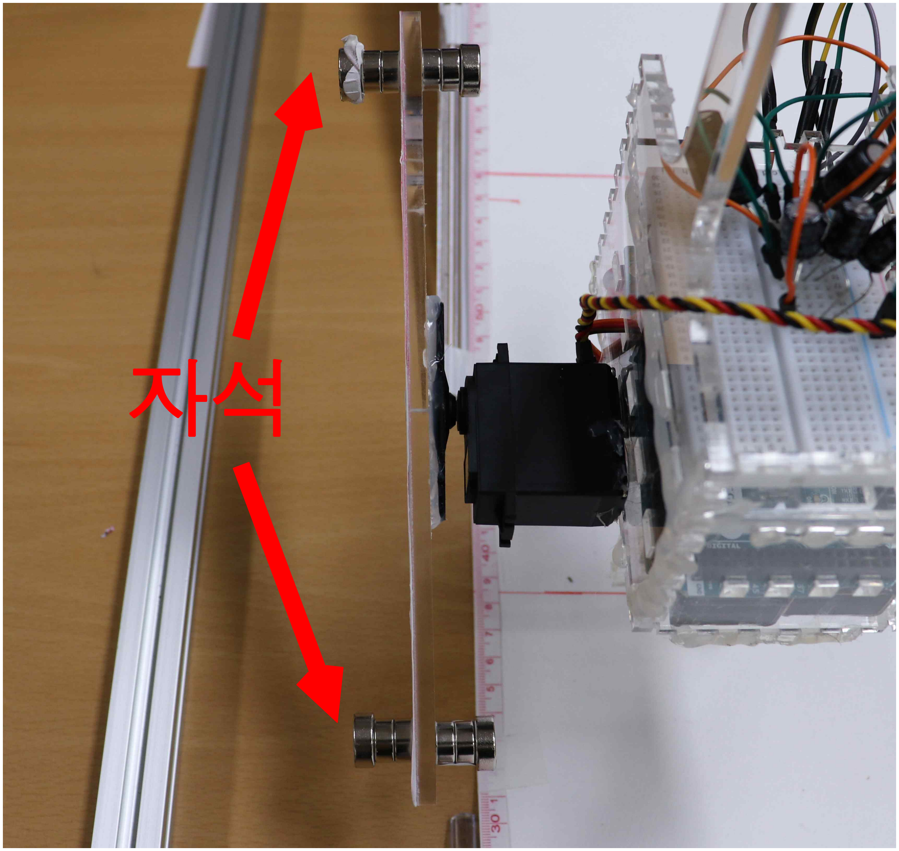
[picture p40: figure]

[그림 28]
근근이 4호 위에서 본 모습

알루미늄 프로파일을 이용해 그네의 프레임을 크게 만들고 베어링과 연마봉을 이 용해 그네의 축을 만들었으며, 레이저 커팅기를 이용해 아크릴을 제단하여 그네의 줄 역할을 하는 부분을 만들었다. 아크릴판을 제단해 서모모터와 아두이노 보드, 건 전지를 넣을 수 있는 그네 본체를 만들었다. 그림 28처럼 근근이의 머리와 발 부분에는 자석을 부착하여 근근이의 무게를 늘

려주었고, 머리와 발 부분의 자석의 갯수를 달리함으로써 근근이의 무게중심의 위 치를 조작할 수 있도록 하였다. 그네의 아랫부분에는 바닥을 바라보는 IR 센서가 있어서 바닥이 흰색인지 검은색

인지 인식할 수 있다. 처음에는 레이저 거리 센서, 초음파 거리 센서, 6축 가속도 센서 등을 사용하여 그네의 위치를 인식하려
하였으나 센서로부터 얻어지는 데이터의 잡음
이 커서 정확한 그네의 위치를 인식하는데 어
려움이 있어 최종적으로 라인 트레이서에 많
이 이용되는 IR 센서를 이용하는 것으로 결정
하였다.
그림 29처럼 근근이의 회전축과 머리 부분
에는 각각 파란색 스티커와 빨간색 스티커를
붙여 나중에 영상 분석을 할 때 (연직 방향
에 대한 그네의 각도)와 (그네 줄에 대한 근

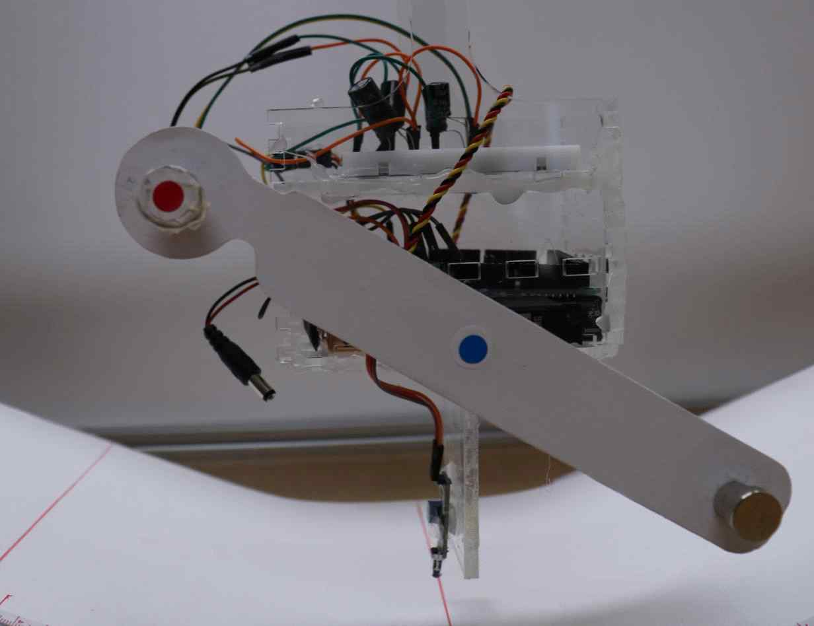
[picture p41: figure]

근이의 각도)를 측정할 수 있도록 하였다. 또 근근이 1호에 비해 토크가 강한(약 11kgf⋅cm) 서보 모터를 사용하였는데, 자석

을 이용해 근근이의 무게를 늘렸을 경우 모터가 움직이는데 매우 큰 전류를 필요로 하였다. 그래서 9V 건전지 하나로 작동시켰을 때는 모터가 움직일 때마다 전압이

[그림 29] 회전축에 파란색 스티커, 머리부
분에 빨간색 스티커

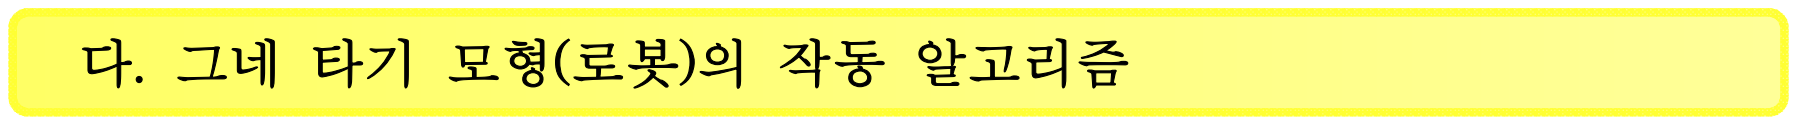
[picture p42: figure]
알고리즘
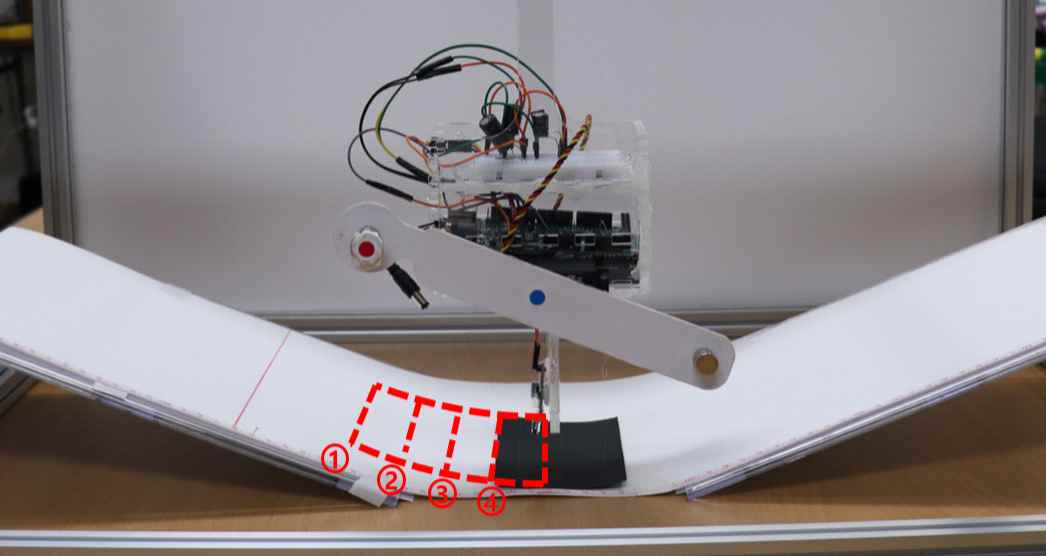
[picture p43: figure]
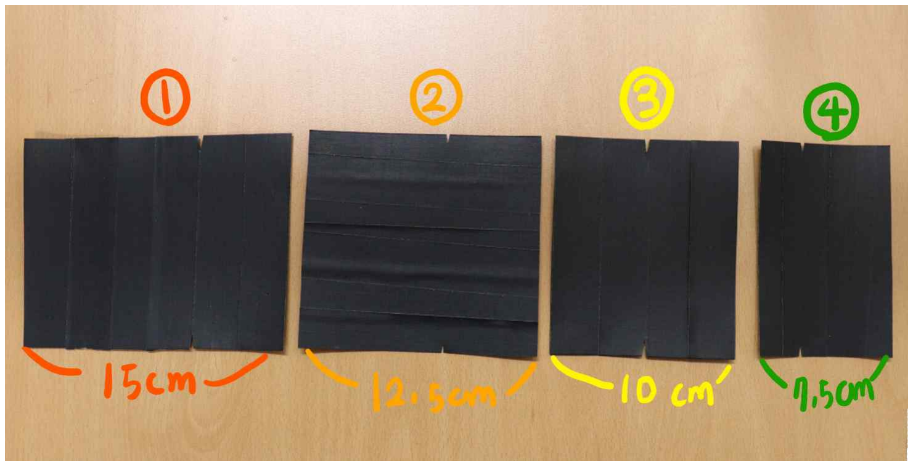
[picture p44: figure]

- 19 -

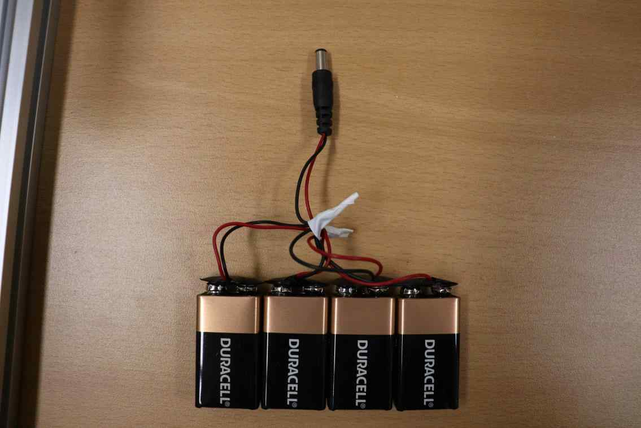
[picture p45: figure]

떨어져 아두이노 보드가 초기화되어 제대로 작동
하지 않는 문제가 있었다. 그래서 그림 30처럼 9V 건전지 4개를 병렬로 연결하여 전류 공급량을 늘 리고, 아두이노에서 모터로 공급하는 전원부에도
대용량 축전기(470F)를 병렬로 부착하여 순간적 으로 많은 전류가 흘러도 전압이 떨어지지 않도록 하였다.

근근이는 IR 센서에 검은색이 인식될 때마다 움직이는데 시계방향으로 60도, 반시계방향 으로 60도 움직이는 것을 반복함으로써 사람이 몸을 접고 펴는 것을 나타낸다.

[그림 31] 검은색 판의 길이를 달리하여 근근이가 몸을 접는 위치를 조작한다.

[그림 32] 길이가 다른 4개의 검은색 판

근근이가 움직이는 아래쪽 바닥에는 [그림 32]의 길이가 다른 검은색 판을 [그림 31]처럼 놓아서 근근이의 움직임을 조작한다.

[그림 30] 4개의 9V 건전지를 병렬 연결

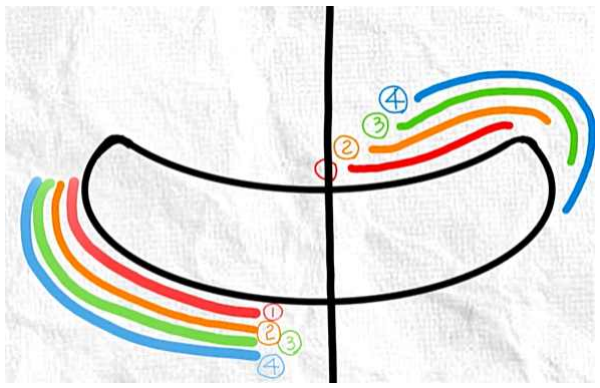
[picture p46: figure]

- 20 -

근근이가 바닥에 있는 검은색 판을 인식하면 그 즉시 시계 방향으로 60도 움직이도록 코 딩하였는데, 아두이노 시스템과 서모모터의 성능 문제로 검은색을 인식한 후 약 0.1초 후에 야 모터가 움직이기 시작하는 문제가 있었다. 그래서 길이가 가장 긴 ⓵번 판을 놓고 근근 이를 왼쪽에서 놓을 경우, 근근이가 ⓵번 판을 인식한 후 약 0.1초 후 움직이므로 실제로는 근근이가 중앙(최하점)을 지나면서 몸을 접기 시작한다. 길이가 2.5cm 짧은 ⓶번 판을 놓을 경우에는 ⓵번 판을 놓았을 때보다 약간 더 늦게 근근이가 움직이기 시작하므로 근근이가 중앙을 약간 지나가서 몸을 접기 시작한다. 이런 방법으로 검은색 판의 길이을 달리하여 근 근이가 몸을 접기 시작하는 위치를 조작하였다. 우리의 조작 변인은 근근이가 몸을 접는 위치이므로 검은색 판의 왼쪽 부분 길이를 조작

하여 4가지 그네타기 전략을 구현하였고, 근근이가 몸을 펴는 위치를 결정하는 검은색 판의 오른쪽 길이는 일정하게(5cm) 유지하였다.
이런 방식으로 우리가 설정한 그네타기 전략 4가지를 개념도로 나타내면 그림 34와 같다. 여기서 검은색 궤적은 근근이가 그네를 타고 있는 것을 나타낸 것이고 색깔로 표시된 궤적

은 그 위치를 지나는 동안 근근이가 몸을 접거나 펴는 동작을 한다는 것을 의미한다. 다시 말해서 ⓵번 전략이 가장 몸을 일찍 접고 ⓸번 전략이 가장 몸을 늦게 접는 것을 의미하며, 위치로 생각하면 ⓵번 전략이 가장 중앙에 가까운 위치에서 몸을 접고 ⓸번 전략이 가장 오

른쪽 끝에서 몸을 접는다고 할 수 있다. 왼쪽 부분에서 몸을 펴는 것은 모두 같은 시간과 위치에서 펴도록 통제 하였다.

[그림 33] 근근이가 몸을 접고 펴는 위치를 나타내는 개념도

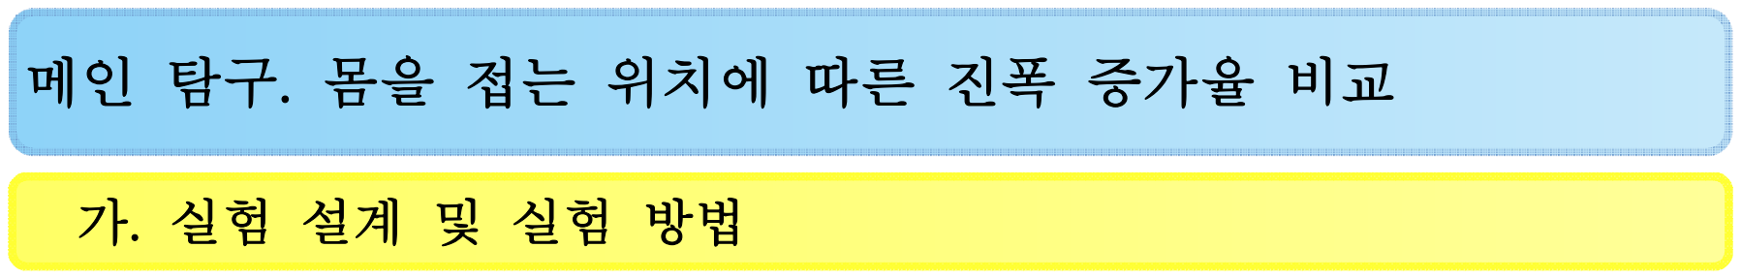
[picture p47: figure]
위치에; 증가율
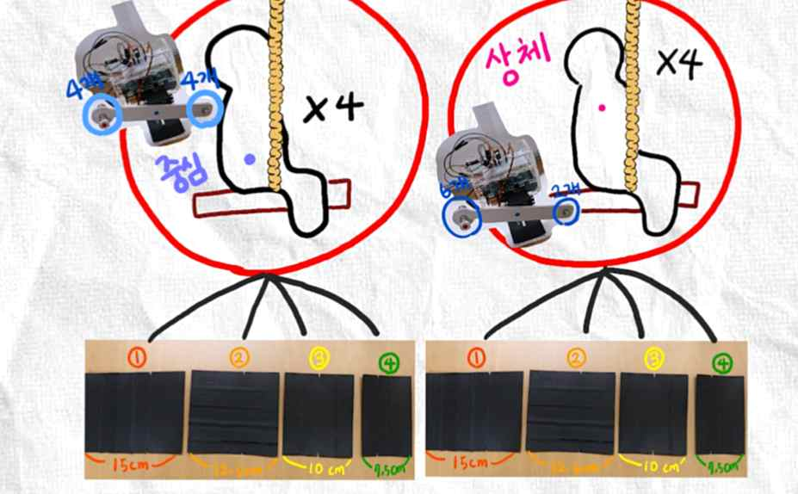
[picture p48: figure]

- 21 -
1) 조작 변인

[그림 34] 두 가지 조작 변인의 설정 근근이의 무게 중심의 위치를 첫 번째 조작 변인으로 설정하였다. 그 이유는 그

네 중앙에서 몸을 접는 사람이 무게 중심 상승 효과를 이용하는 것으로 보였기 때 문에 이를 확인하기 위해서이다. 즉, 근근이의 무게중심이 근근이의 회전축에 있으 면 몸을 접어도 무게 중심 상승 효과가 일어나지 않고, 무게중심이 상체 쪽에 있으 면 몹을 접을 때 무게중심 상승 효과가 있을 것이기 때문에 그 차이를 알아보고자 하였다. 근근이의 무게 중심 위치는 앞에서 언급한 대로 머리와 발에 부착하는 자 석의 개수로 조작하였다.
두 번째 조작 변인은 근근이가 몸을 접는 위치인데, 역시 앞에서 설명한 대로 그 네 및에 놓는 검은색 판의 길이를 조작함으로써 근근이가 몸을 접는 위치를 조작하 였다.
어처럼 8가지 경우의 실험를 설정하였고, 8가지 실험을 총 3번 반복하여 모두 24 번의 실험을 실시하였다. 2) 종속 변인

그네의 진폭이 얼마나 빨리 커지는지, 즉 진폭 증가율을 종속 변인으로 설정하였 다. 진폭 증가율을 측정하는 과정은 다음과 같다. 가) 근근이가 그네 타는 모습을 영상으로 촬영한다. 나) 촬영된 영상속의 파란 스티커(근근이의 회전축)를 Tracker로 추적하여 시

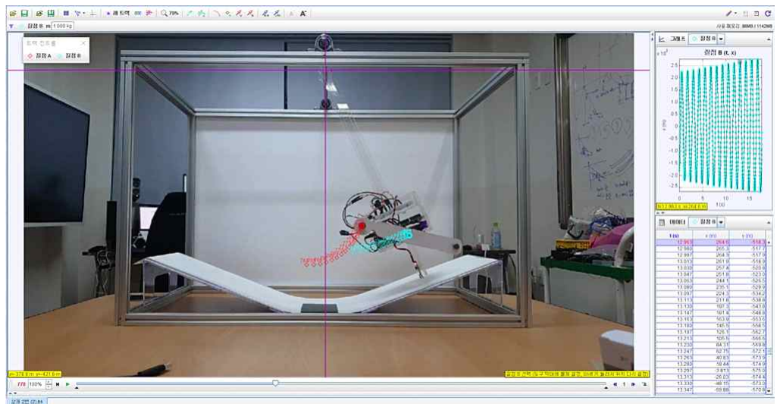
[picture p49: figure]
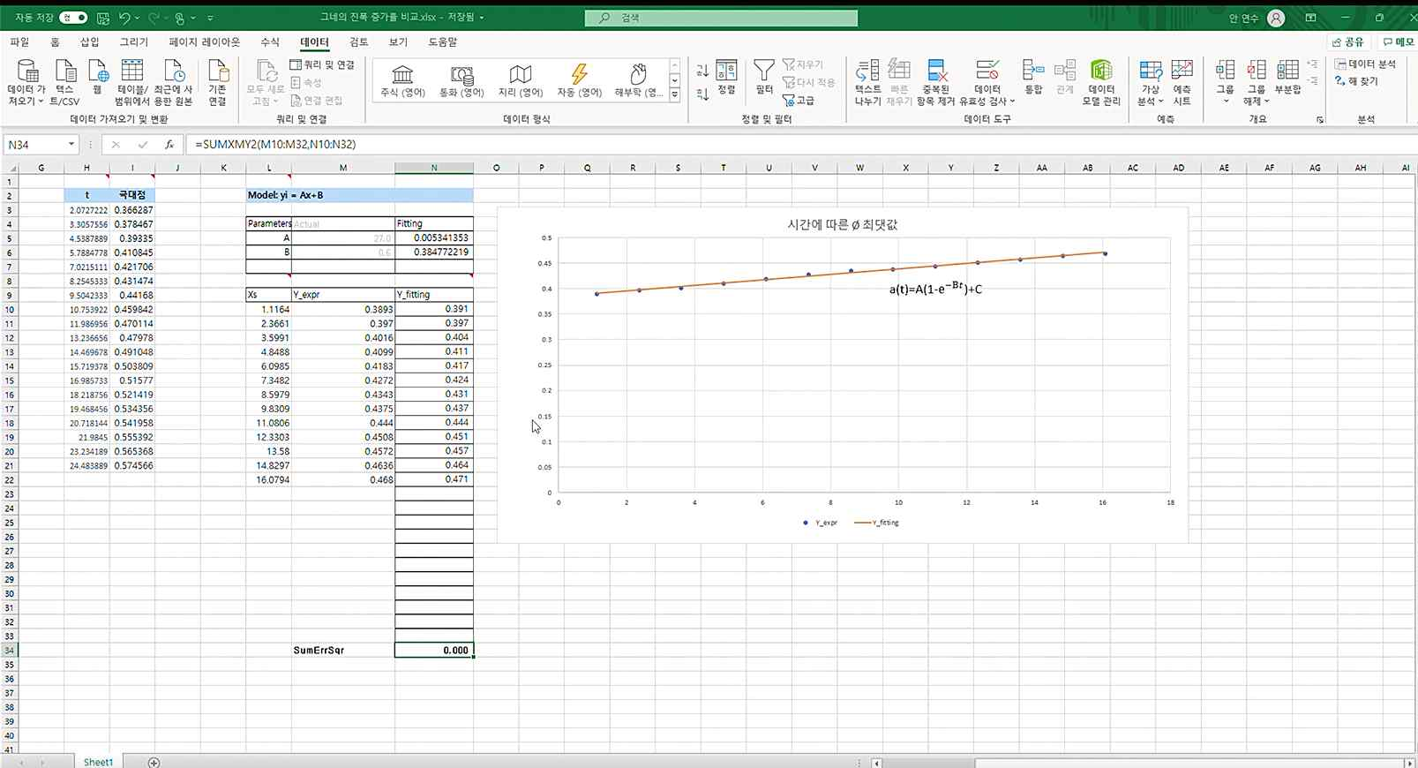
[picture p50: figure]

- 22 -

간에 따른 x, y 좌표값을 얻는다.

[그림 35] 트래커로 그네의 운동을 추적하는 장면

다) Excel을 이용하여 x, y 좌표값으로부터 그네의 각변위 값을 얻는다. 라) Excel의 Filter 함수와, Vlookup 함수를 이용해 각변위의 극댓값들만 골라

낸다. 마) 최소 자승법(Least Square Method)을 이용해 1차 함수 형태의 추세선 식

을 구한다. 바) 추세선의 기울기 값을 진폭 증가율로 사용한다.

[그림 36] 엑셀 함수와 최소자승법을 이용해 1차 함수 형태의 추세선을 구함

3) 통제 변인
근근이가 그네 타는 장면을 영상으로 촬영하여 tracker 프로그램, excel 프로그램 으로 분석하기 위해서는 카메라의 촬영 각도, 그네의 운동 시작 위치, 그네를 놓는

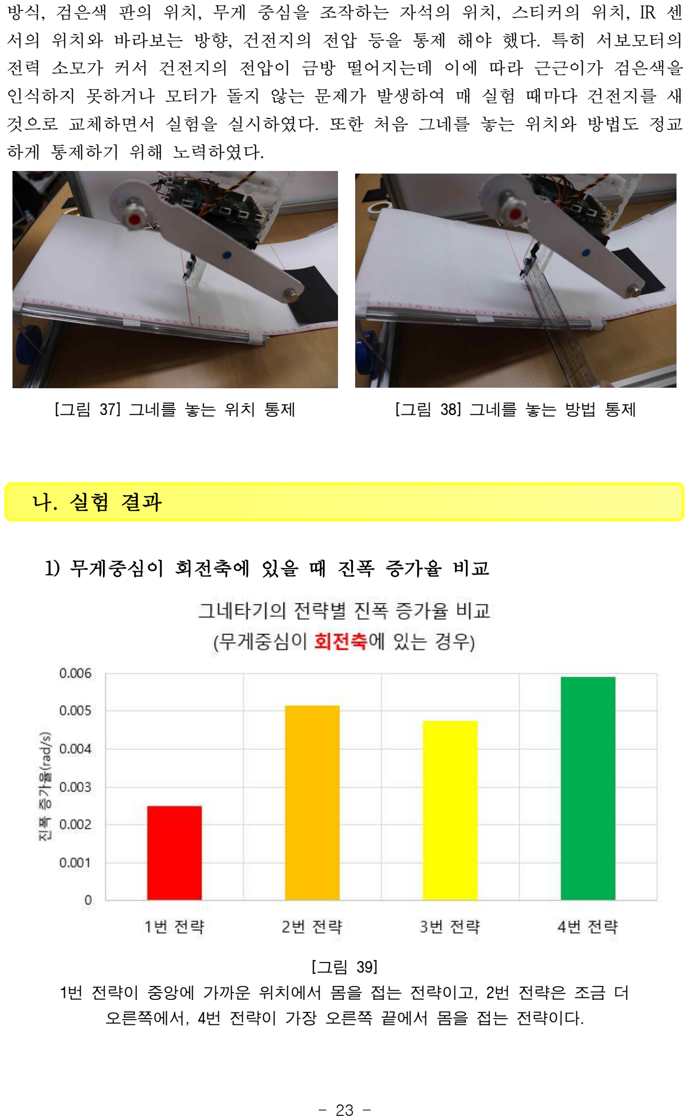
[picture p51: page 26]

- 23 -

방식, 검은색 판의 위치, 무게 중심을 조작하는 자석의 위치, 스티커의 위치, IR 센 서의 위치와 바라보는 방향, 건전지의 전압 등을 통제 해야 했다. 특히 서보모터의 전력 소모가 커서 건전지의 전압이 금방 떨어지는데 이에 따라 근근이가 검은색을 인식하지 못하거나 모터가 돌지 않는 문제가 발생하여 매 실험 때마다 건전지를 새 것으로 교체하면서 실험을 실시하였다. 또한 처음 그네를 놓는 위치와 방법도 정교 하게 통제하기 위해 노력하였다.

[그림 37] 그네를 놓는 위치 통제

[그림 38] 그네를 놓는 방법 통제

나. | 실험 | 결과
1) 무게중심이 회전축에 있을 때 진폭 증가율 비교

[그림 39]
1번 전략이 중앙에 가까운 위치에서 몸을 접는 전략이고, 2번 전략은 조금 더 오른쪽에서, 4번 전략이 가장 오른쪽 끝에서 몸을 접는 전략이다.

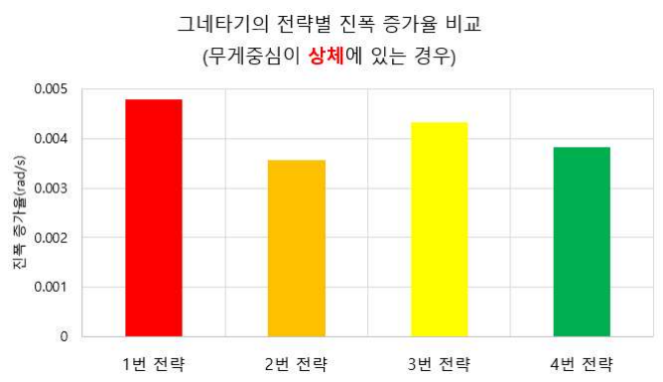
[picture p52: figure]
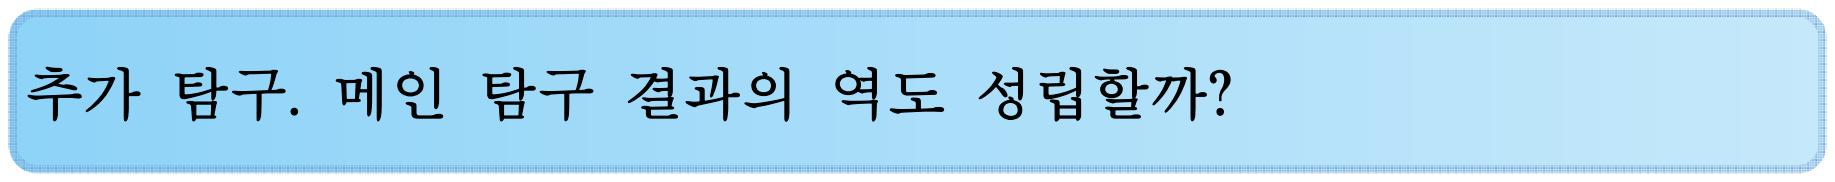
[picture p53: figure]
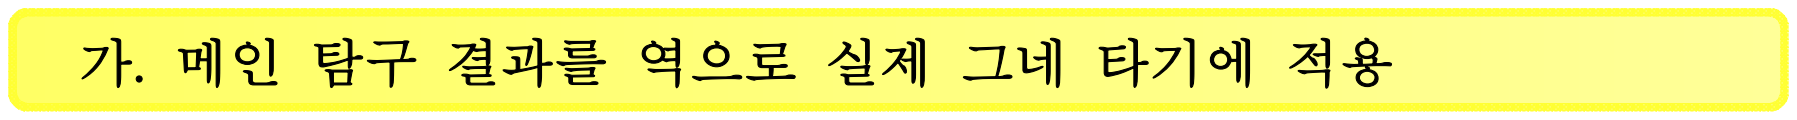
[picture p54: figure]
결과를; 역으로; 타기에

- 24 -
2) 무게중심이 상체에 있을 때 진폭 증가율 비교

[그림 40]
1번 전략이 중앙에 가까운 위치에서 몸을 접는 전략이고, 2번 전략은 조금 더 오른쪽에서, 4번 전략이 가장 오른쪽 끝에서 몸을 접는 전략이다.
3) 실험 결과 해석

l 무게 중심이 회전축에 있을 때는 몸을 접을 때 무게 중심 상승 효과가 없으므로 돌림힘의 작용 반작용 효과가 가장 크게 나타나는 오른쪽 끝에서 몸을 접는 4번 전략이 가장 진폭 증가율이 큰 것으로 해석할 수 있다. l 무게 중심이 상체에 있는 경우에는 몸을 접을 때 돌림힘의 작용 반작용 효과 뿐

만 아니라 무게 중심의 상승 효과도 있기 때문에 무게 중심의 상승 효과가 가장 크게 나타나는 중앙부에서 몸을 접는 1번 전략이 가장 진폭 증가율이 큰 것으로
해석할 수 있다. 추가 | 탐구. | 메인 | 탐구 | 결과의 | 역도 | 성립할까?

우리는 직접 만든 그네 타기 로봇 근근이를 이용한 실험을 통해 무게중심이 상체

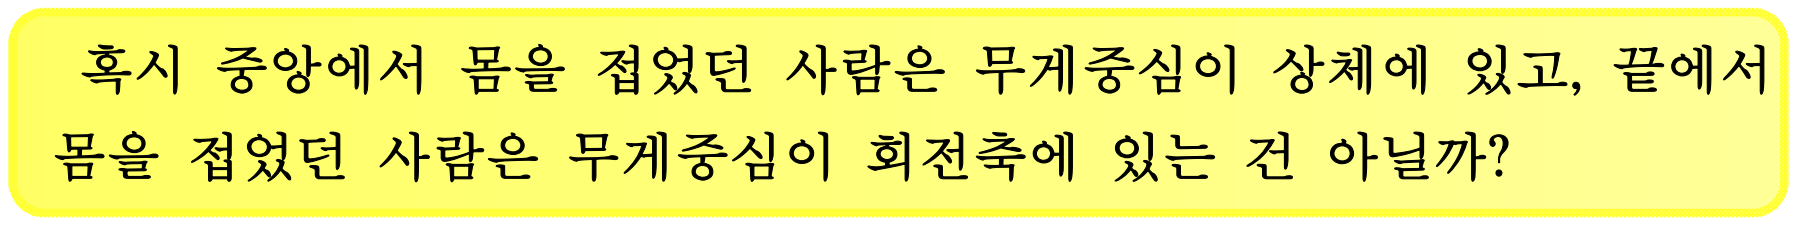
[picture p55: figure]
접었던; 사람은; 무게중심이; 회전축에; 아닐까?
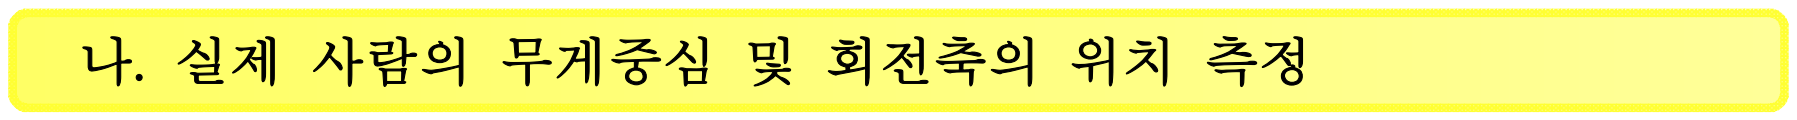
[picture p56: figure]
사람의; 무게중심; 회전축의
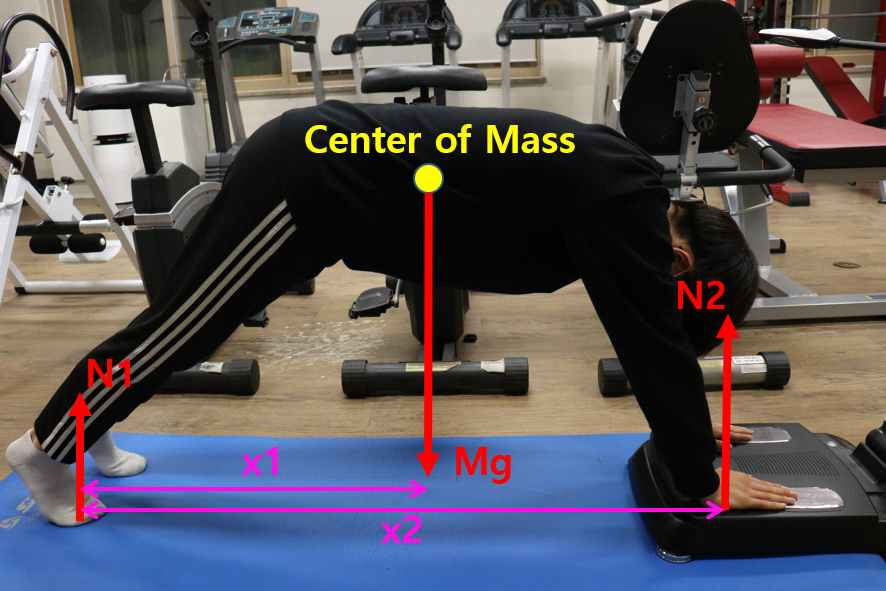
[picture p57: figure]

- 25 -
에 | 있는 | 경우 | 그네가 | 중앙부를 | 지날 | 때 | 몸을 | 접는 | 것이 | 유리하다는 | 결과를 | 얻었다. 우리는 | 이 | 결과를 | 우리 | 탐구의 | 동기가 | 되었던 | 처음 | 문제 | 상황에 | 역으로 | 대입해 | 보
면서 | 깜작 | 놀랄 | 새로운 | 질문을 | 떠올렸다. 혹시 | 중앙에서 | 몸을 | 접었던 | 사람은 | 무게중심이 | 상체에 | 있고, | 끝에서

우리는 이 질문에 대한 답을 얻기 위해 실제 그네를 탔던 두 사람의 무게중심과 회전축의 위치를 구해 보았다. 1) 실제 사람의 무게중심 위치 측정

[그림 41] 실제 사람의 무게 중심 위치 측정을 위한 자유물체도
무게중심의 위치를 측정하는 방법은 [그림 41]의 자유물체도를 보면 알 수 있다. 사람의 무게를 , 중력가속도를 , 무게중심(C.M.)으로부터 상체쪽, 하체쪽의 수직

항력을 각각

- 로 하였다. 또한 발끝부터 무게중심까지의 축 방향 거리를 , 발끝부터 손끝까지 축 방향 거리를 라고 하였고, 시계반대방향을 (+)의 회전 방

향으로 잡았다. 이때 발끝점을 회전축으로 삼고 돌림힘의 평형 식을 쓰면 ⋯ ①의 식을 얻을 수 있고, 연직 방향 힘의 평형 식을 쓰면

⋯ ②의 식을 구할 수 있다. ①, ②식을 연립하면 ∴

의 식을

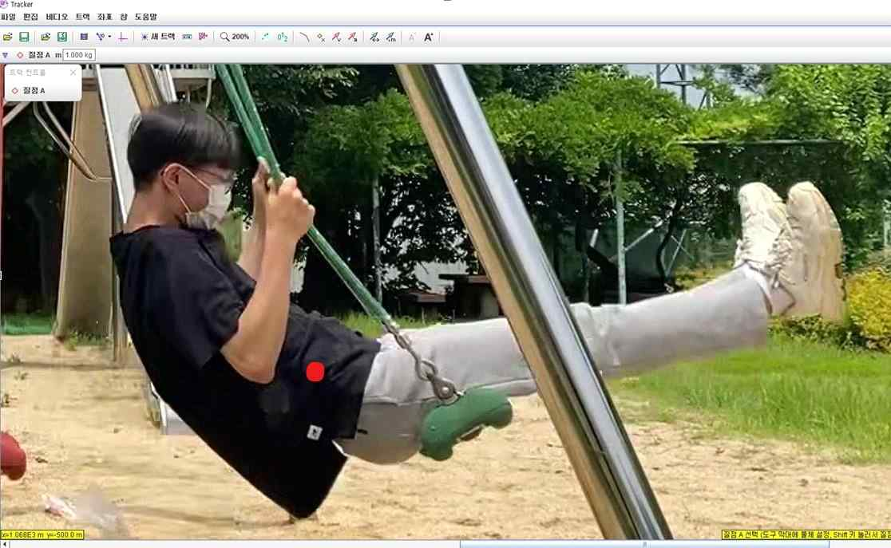
[picture p58: figure]
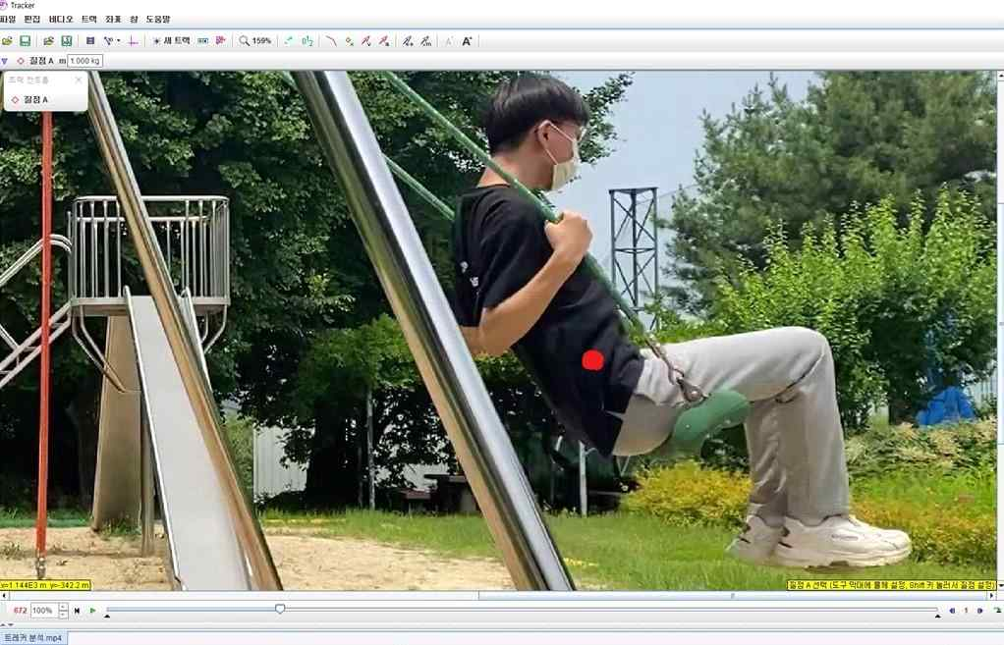
[picture p59: figure]
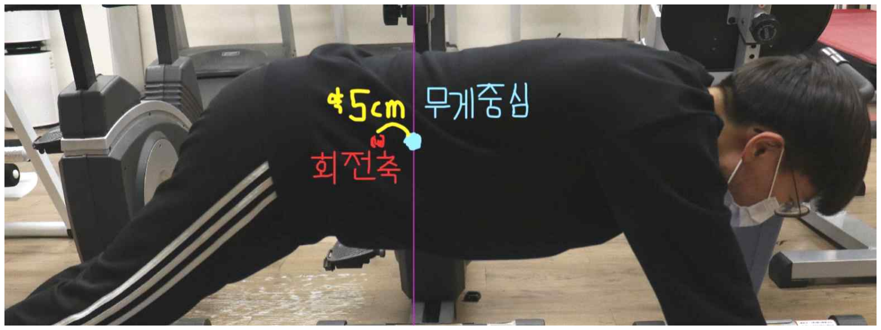
[picture p60: figure]
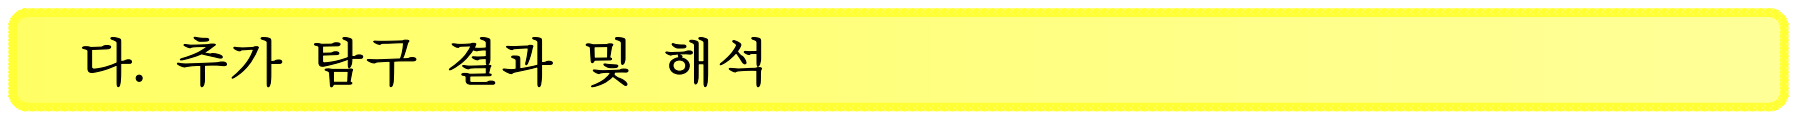
[picture p61: figure]

- 26 -

얻을 수 있으므로 와 와 를 측정하면 을 구할 수 있다. 직접 두 사람이 그림 41처럼 엎드려서 무게를 측정해 보니 중앙에서 몸을 접었던

사람은

의 값이 약 0.57, 끝에서 몸을 접었던 사람은 약 0.66로 측정 되었다.

### 나) 회전축 위치 측정

회전축의 위치는 [그림 42]와 [그림 43]과 같이 당시 직접 실제 그네 타기를 하며 촬영하였던 영상을 tracker 프로그램으로 한 프레임씩 돌려보며 몸을 접는 동안 가 장 움직이지 않는 점을 찾았다.

[그림 42] Tracker 프로그램에서 회전축 위치를 찾는 과정 사진1

[그림 43] Tracker 프로그램에서 회전축 위치 를 찾는 과정 사진1

이렇게 찾은 무게중심과 회전축의 위치를 몸 위에 나타내면 그림 42, 43과 같다.

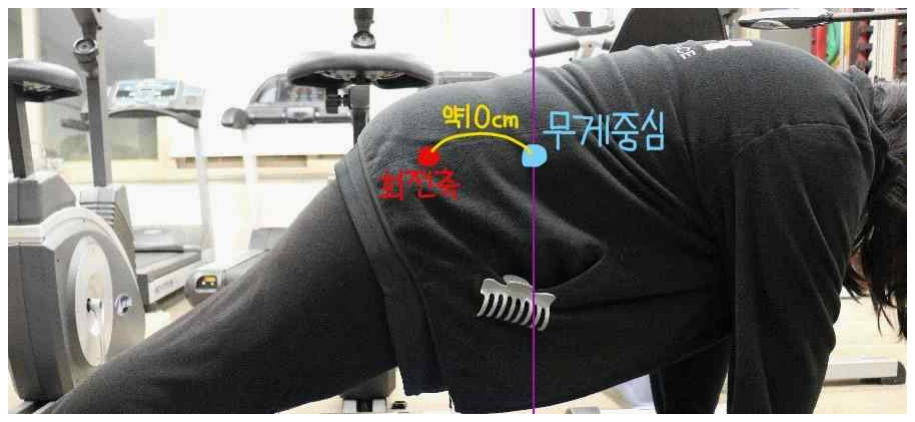
[picture p62: figure]

[그림 44] 학생 A의 무게중심과 회전축의 위 치 차이 분석

[그림 45] 학생 B의 무게중심과 회전축의 위치 차이 분 석

그네를 탈 때 중앙에서 몸을 접었던 학생 A의 무게중심과 회전축 사이의 거리는 약 10cm, 끝에서 몸을 접었던 학생 B의 무게중심과 회전축 사이의 거리는 약 5cm 로 측정되었다. 이 결과를 바탕으로 우리는 학생 A의 무게중심이 회전축으로부터 더 멀리 있기 때

문에 몸을 접었을 때 무게중심 상승 효과가 상대적으로 더 크기 때문에 본능적으로 중앙에서 몸을 접는 전략을 사용했을 것으로 추측한다.
비록 표본이 두 개 밖에 되지 않아 일반화 할 수는 없지만, 더 많은 사람들을 대

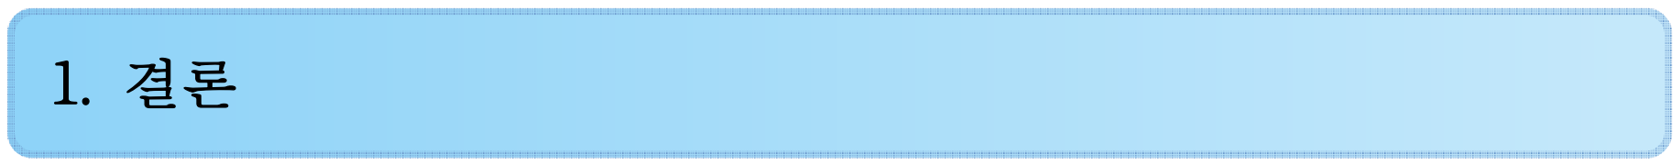
[picture p63: figure]
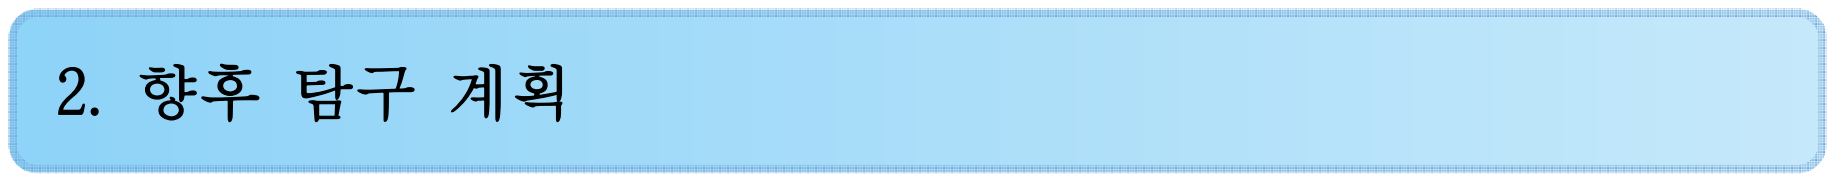
[picture p64: figure]

- 27 -

상으로 이와 같은 실험을 실시하여 몸을 접는 위치와 무게중심 위치와의 상관관계 가 있음을 알아낸다면 사람들이 경험을 통해 본능적으로 학습한 그네타기의 방법이 역학적으로도 자신의 체형에 맞는 최적의 방법일 것이라는 아주 재미있는 결론을 얻을 수 있을 것이다.

# Ⅴ 결론 및 향후 탐구 계획

### 가) 앉아서 그네 타기에서

- 무게 중심의 위치가 상체에 위치한 사람은 그네가 중앙(최저점)을 지날 때 몸을 접는 것이 가장 효과적인 진폭 증가 방법이고, - 무게 중심의 위치가 회전축에 위치한 사람은 그네가 끝점(최고점)

을 지날 때 몸을 접는 것이 가장 효과적인 진폭 증가 방법임을 직접 만든 그네 타기 로봇을 이용한 실험을 통해 알아내었다. 나) 우리가 어려서부터 경험을 통해 본능적으로 익혀서 타고 있는 그네

타기의 방법이 역학적으로도 자신의 체형에 맞는 최적의 방법일 가능
성을 | 발견하였고 | 간단한 | 측정을 | 통해 | 확인하였다.

가) 우리가 만들어 사용한 그네 타기 로봇의 단점을 보완하여 더 정교한 실험을 해 보고 싶다. 나) 더 많은 사람들을 대상으로 앉아서 그네 타기에서 몸을 접는 위치와

무게중심 위치와의 상관관계를 측정하는 실험을 실시해서 사람들이 경험을 통해 본능적으로 학습한 그네타기의 방법이 역학적으로도 자 신의 체형에 맞는 최적의 방법일 것이라는 가설을 검증해 보고 싶다. 다) 시행 착오를 통해 최적의 알고리즘을 찾아가는 유전 알고리즘과 같

은 인공지능에 대해 공부해서 최적의 그네타기 전략을 구사하는 로 봇을 만들고 싶다.

- 28 -

# VI 참고문헌

1. 그네 타기의 역학적 원리를 알아내어 가장 그네를 잘 타는 로봇 제작하기- 경남 과학고 STEAM R&E 결과보고서 (2013.5~2013.12)
2. How to Pump a Swing, Stephen Wirkus 외 2인 (1998)
3. 나! 그네, KOSMOS (KAIST부설 한국과학영재학교 온라인 과학매거진 코스모스) 이준민 (2020) https://www.ksakosmos.com/post/_%EB%82%98-%EA%B7%B8%EB%84%A4
4. How Do You Go Up in a Swing? http://www.physicsinsights.org/up_in_a_swing.html
5. Pumping a playground swing, Auke A. Post 외 3인 (2007)
6. The pumping of a swing from the seated position, William B. Case 외 1인 (1999)
7. Time-optimal control of a swing, Jayant E. Kulkarni (2003)
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
