MOSW626/Swinging_on_a_swing_Robot_Project_-2021-/2021 그네타기 전람회 그림.png

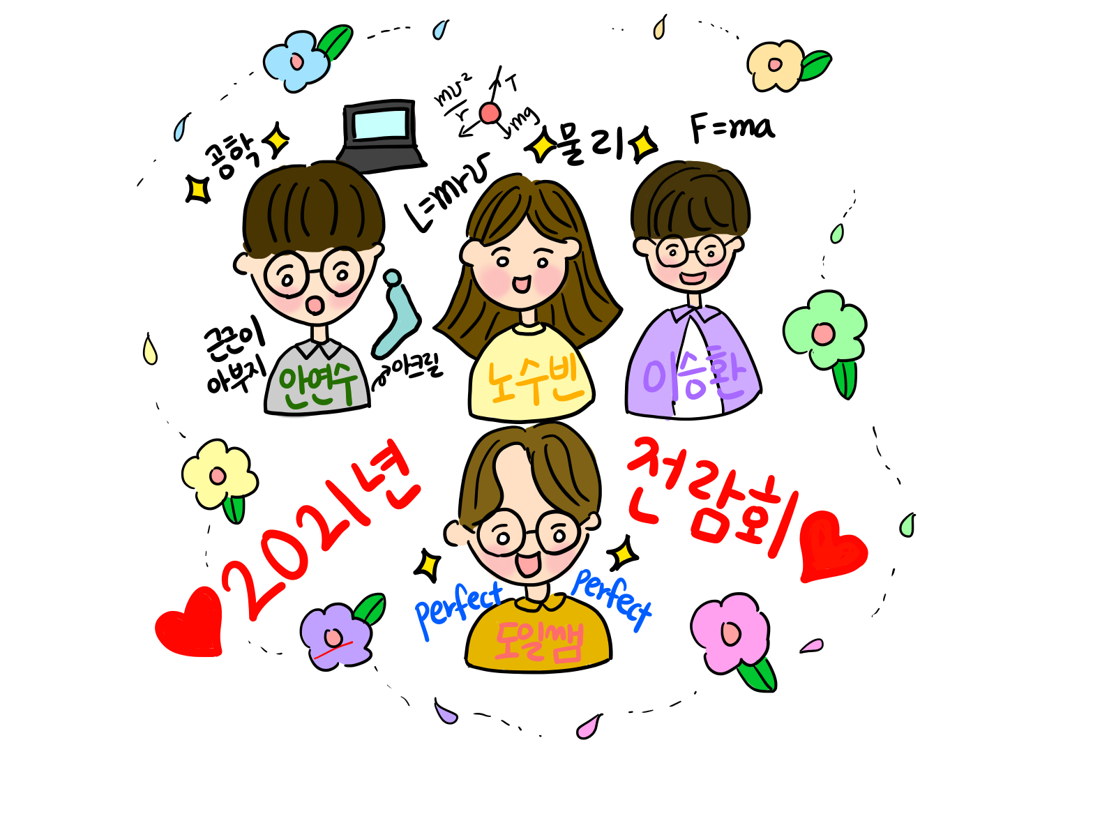
2021 그네타기 전람회 그림.png
