MOSW626/Swinging_on_a_swing_Robot_Project_-2021-/src/rmsp.png

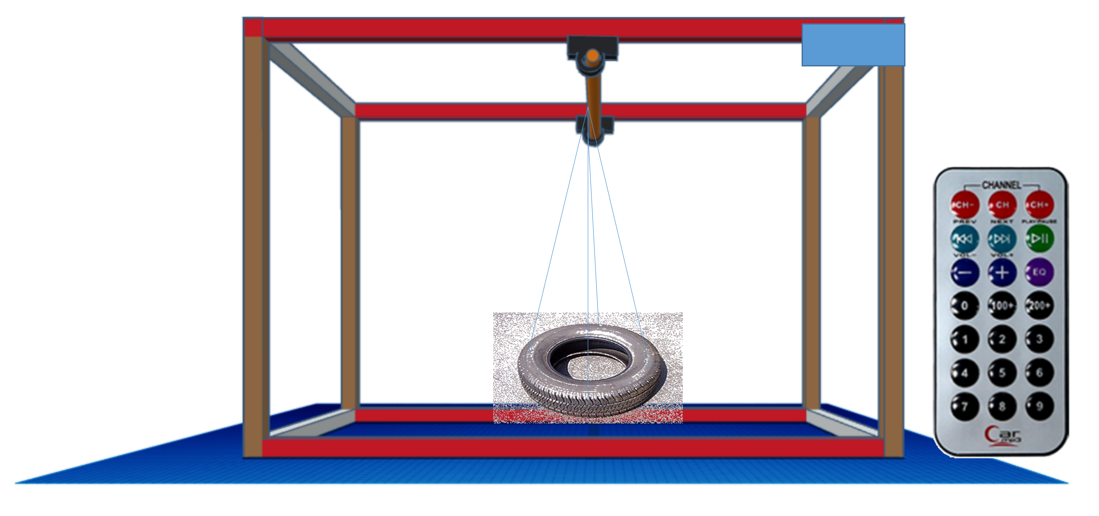
src/rmsp.png
