MOSW626/Swinging_on_a_swing_Robot_Project_-2021-/src/센서 예제/적외선 리모콘/06_적외선_리모컨으로_보낸_신호의_16진수_값.png

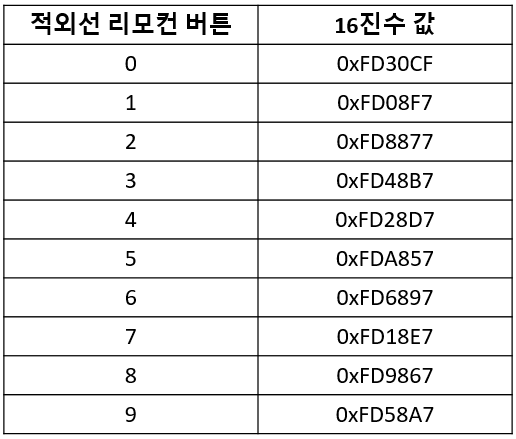
src/센서 예제/적외선 리모콘/06_적외선_리모컨으로_보낸_신호의_16진수_값.png
