MOSW626/Swinging_on_a_swing_Robot_Project_-2021-/src/센서 예제/적외선 리모콘/07_적외선_리모컨으로_LED_켜고_끄기의_실행_결과.png

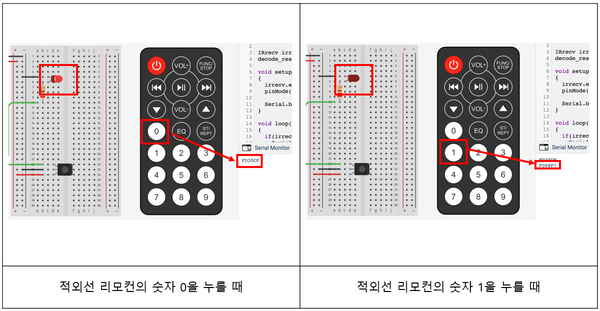
src/센서 예제/적외선 리모콘/07_적외선_리모컨으로_LED_켜고_끄기의_실행_결과.png
