MOSW626/Swinging_on_a_swing_Robot_Project_-2021-/src/센서 예제/초음파 거리 센서/0.png

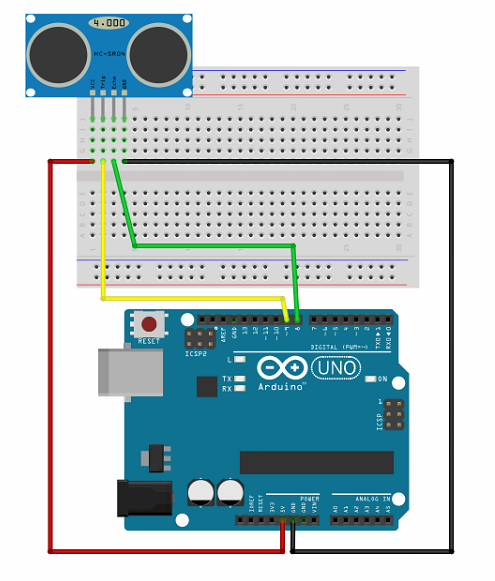
src/센서 예제/초음파 거리 센서/0.png
