MOSW626/Swinging_on_a_swing_Robot_Project_-2021-/src/실험 데이터 즉각/test1.xlsm

TIME | Z | Timer | Counter | millis
1030 | -1.01
1053 | -1
1078 | -1
1101 | -1
1126 | -1.01
1149 | -1
1174 | -1
1198 | -1.01
1222 | -1.01
1246 | -1
1270 | -1
1294 | -1.01
1318 | -1
1342 | -1.01
1367 | -1
1390 | -1
1415 | -1
1438 | -1
1462 | -1
1486 | -1
1510 | -1
1534 | -1
1558 | -1
1583 | -1
1606 | -1
1631 | -1
1654 | -1
1679 | -1
1702 | -1.01
1727 | -1
1751 | -1
1775 | -1.01
1799 | -1
1823 | -1
1847 | -1
1870 | -1
1895 | -1
1918 | -1
1943 | -1.01
1967 | -1
1991 | -1
2015 | -1
2039 | -1
2063 | -1
2087 | -1.01
2111 | -1
2136 | -1
2159 | -1.01
2184 | -1.01
2207 | -1
2232 | -1
2255 | -1.01
2280 | -1
2304 | -1
2327 | -1
2352 | -1
2375 | -1.01
2400 | -1
2423 | -1
2448 | -1
2471 | -1.01
2496 | -1
2520 | -1
2544 | -1
2568 | -1
2592 | -1
2616 | -1
2640 | -1.01
2664 | -1
2689 | -1
2712 | -1
2736 | -1
2760 | -1.01
2784 | -1.04
2808 | -1.02
2832 | -1.06
2856 | -1.15
2880 | -1.22
2905 | -1.32
2928 | -1.32
2953 | -1.35
2976 | -1.23
3001 | -1.08
3024 | -1.04
3049 | -0.95
3073 | -0.91
3097 | -0.83
3121 | -0.8
3145 | -0.79
3169 | -0.8
3193 | -0.7
3217 | -0.86
3240 | -0.92
3265 | -0.99
3289 | -1.07
3313 | -1.14
3337 | -1.23
3361 | -1.29
3385 | -1.36
3409 | -1.42
3433 | -1.45
3458 | -1.45
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
