MOSW626/Swinging_on_a_swing_Robot_Project_-2021-/src/Line Follower Arduino – ForbiddenBit.pdf

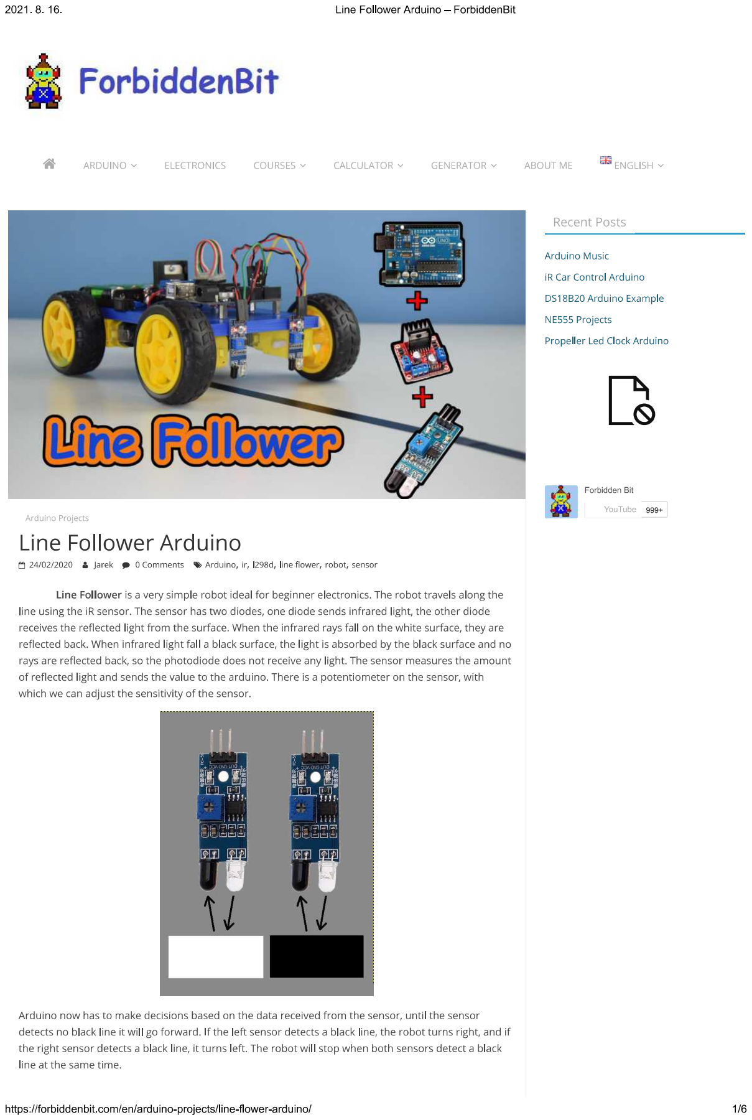
[picture p78: page 1]

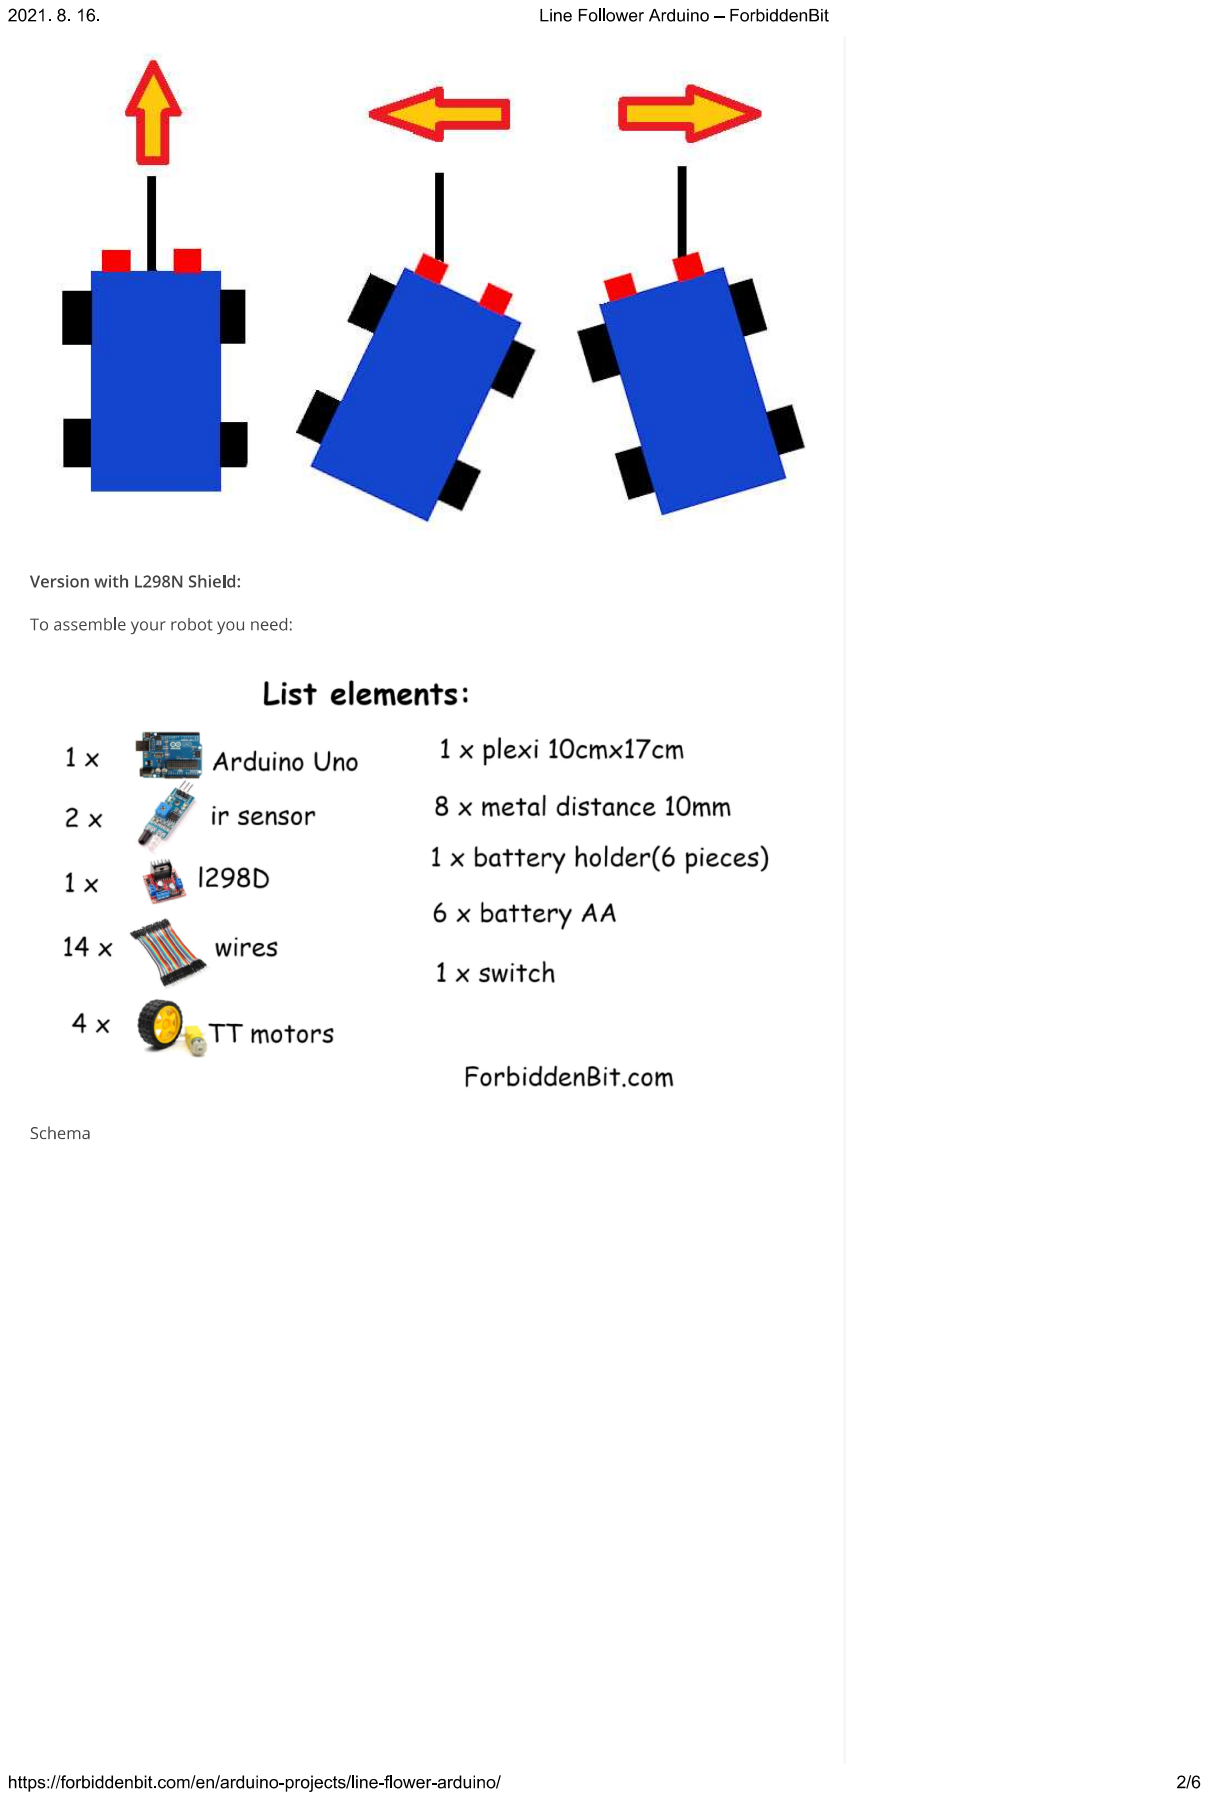
[picture p79: page 2]

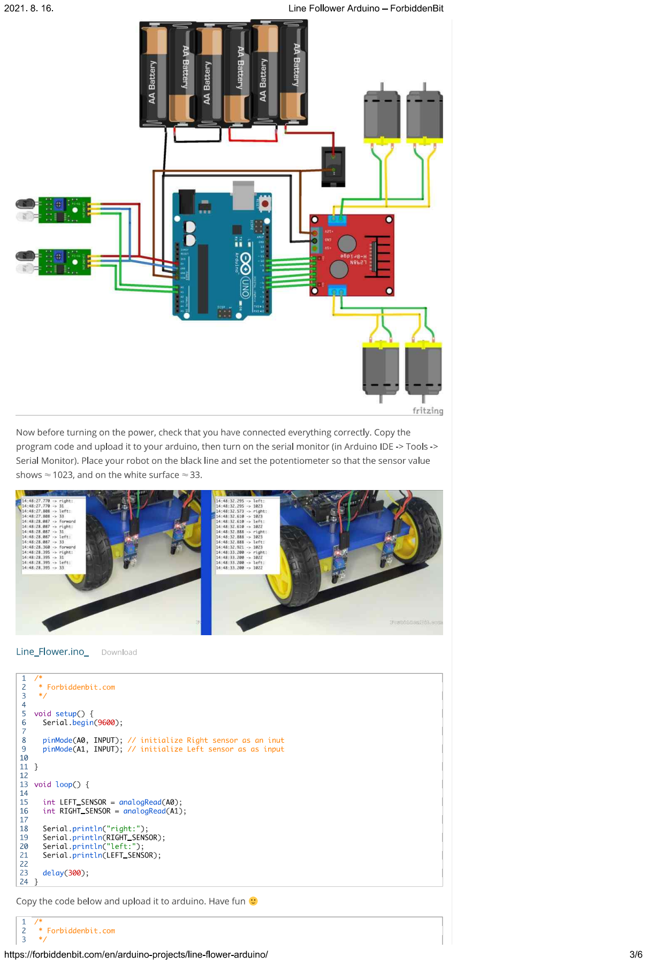
[picture p80: page 3]

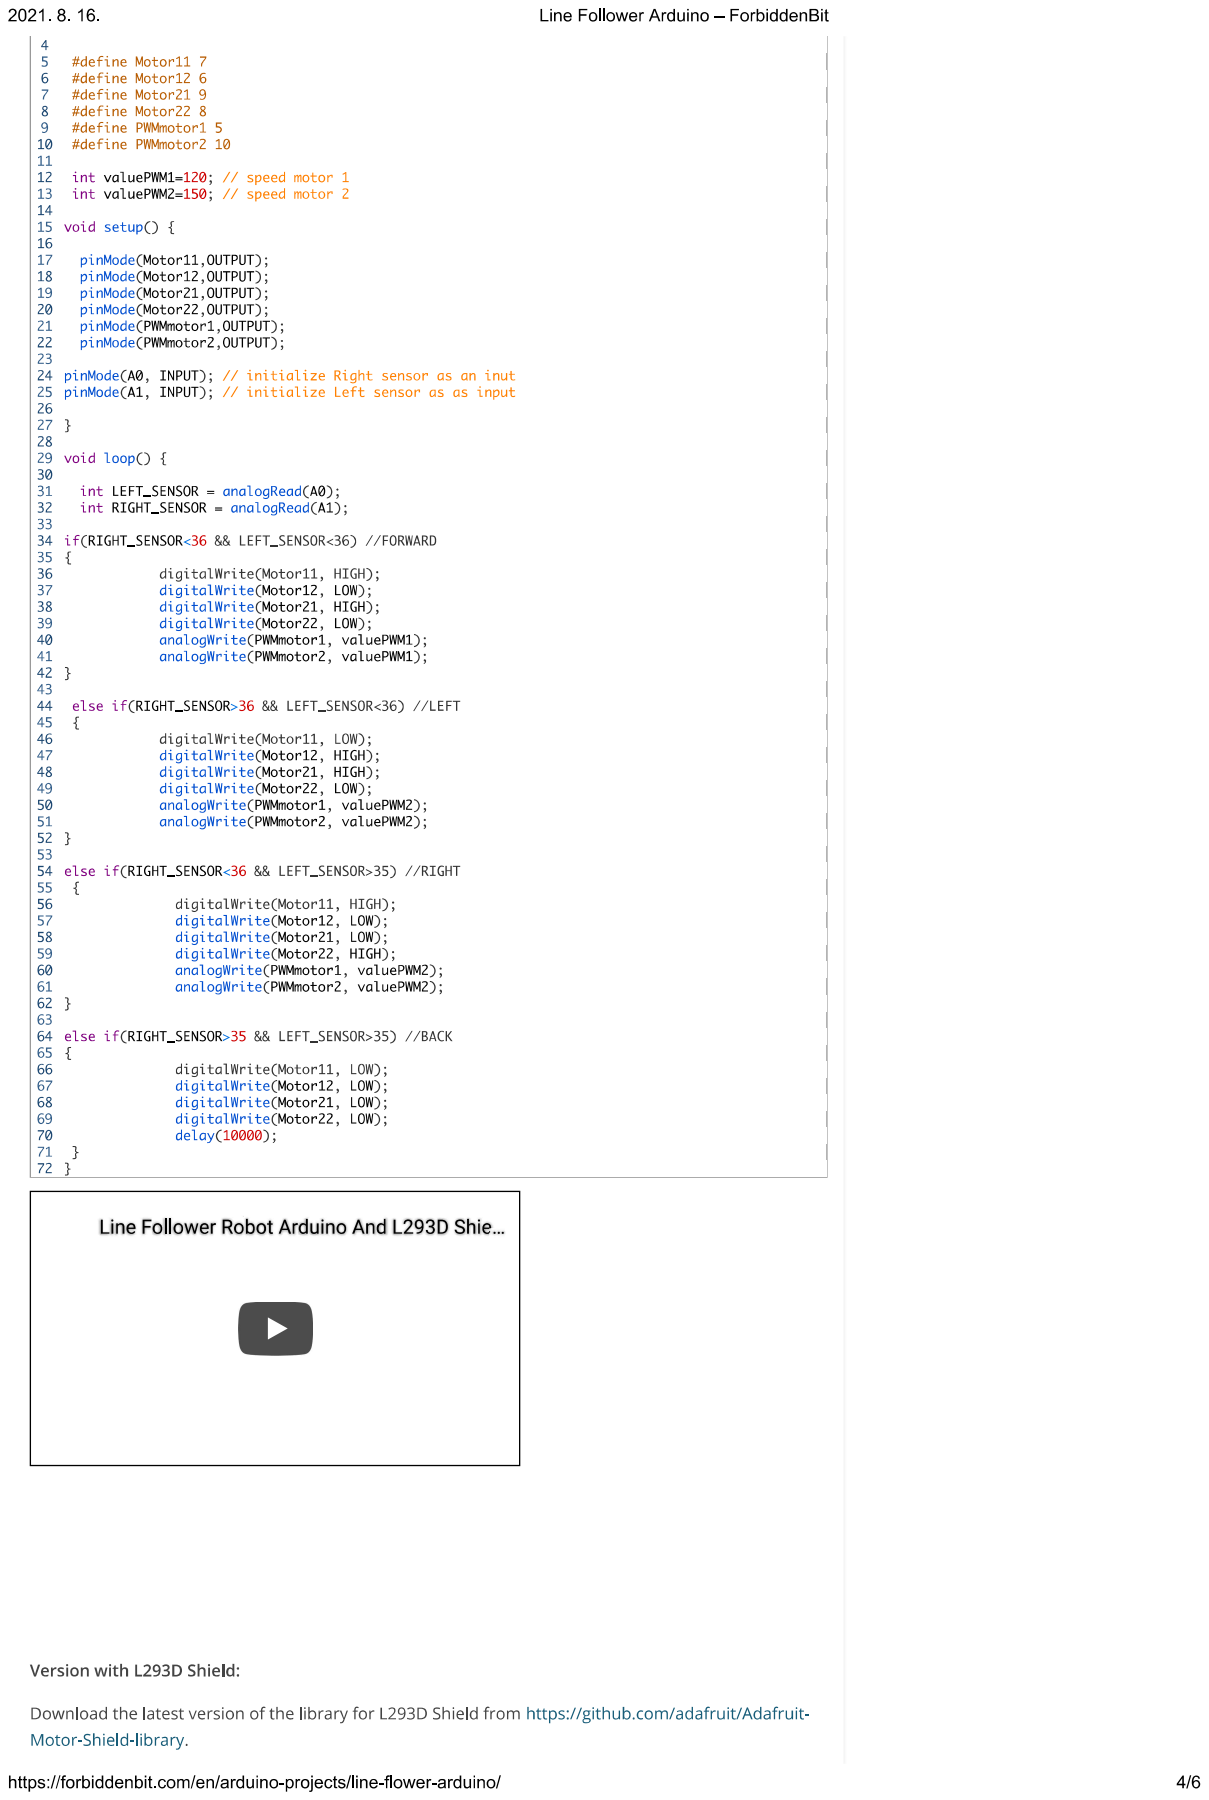
[picture p81: page 4]

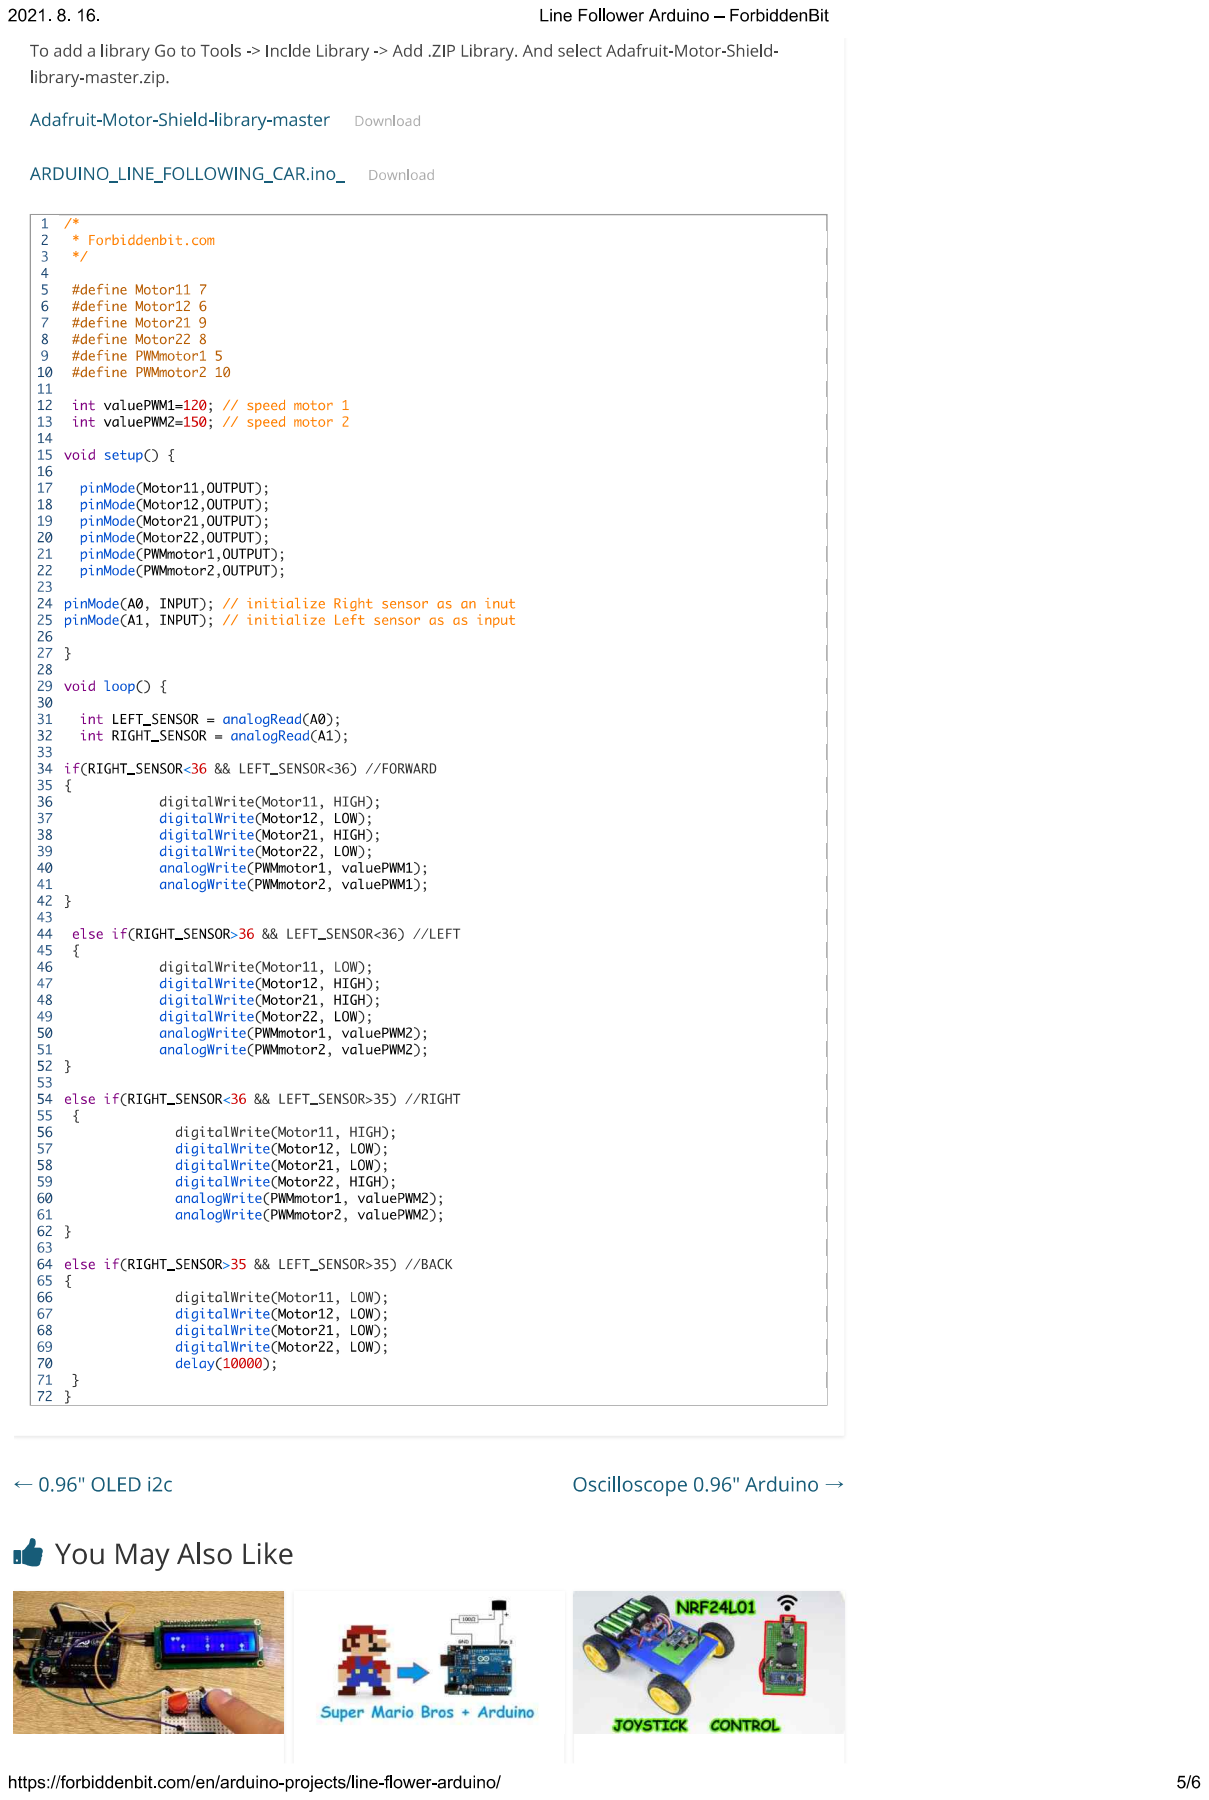
[picture p82: page 5]

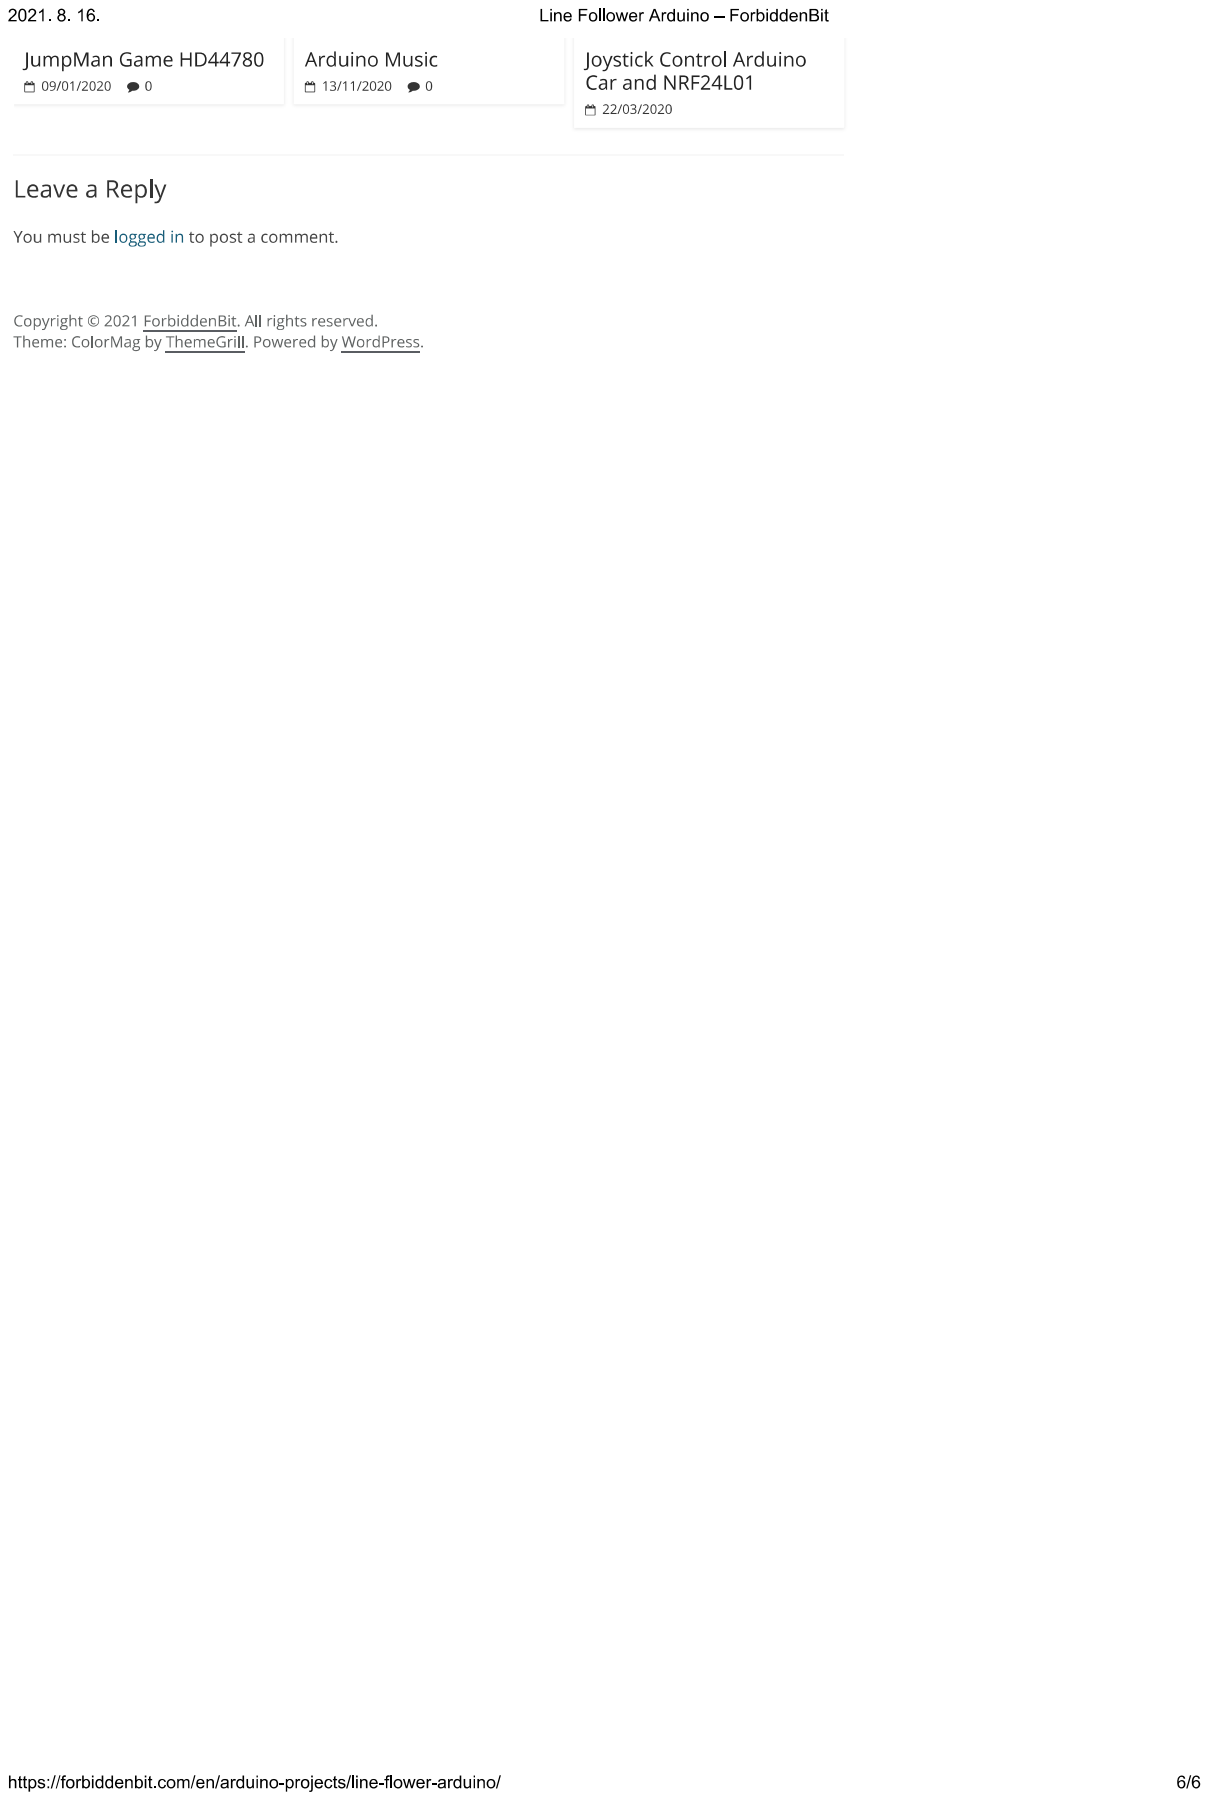
[picture p83: page 6]
