MOSW626/Swinging_on_a_swing_Robot_Project_-2021-/(list of files, drawings)

Other design files:
src/Untitled Sketch.fzz
src/센서 예제/레이저 거리 센서/lazer.fzz
